bitaxeorg/bitaxeproto/bitaxeProto.kicad_pcb

## KiCad design bitaxeProto.kicad_pcb (2026-08-12)

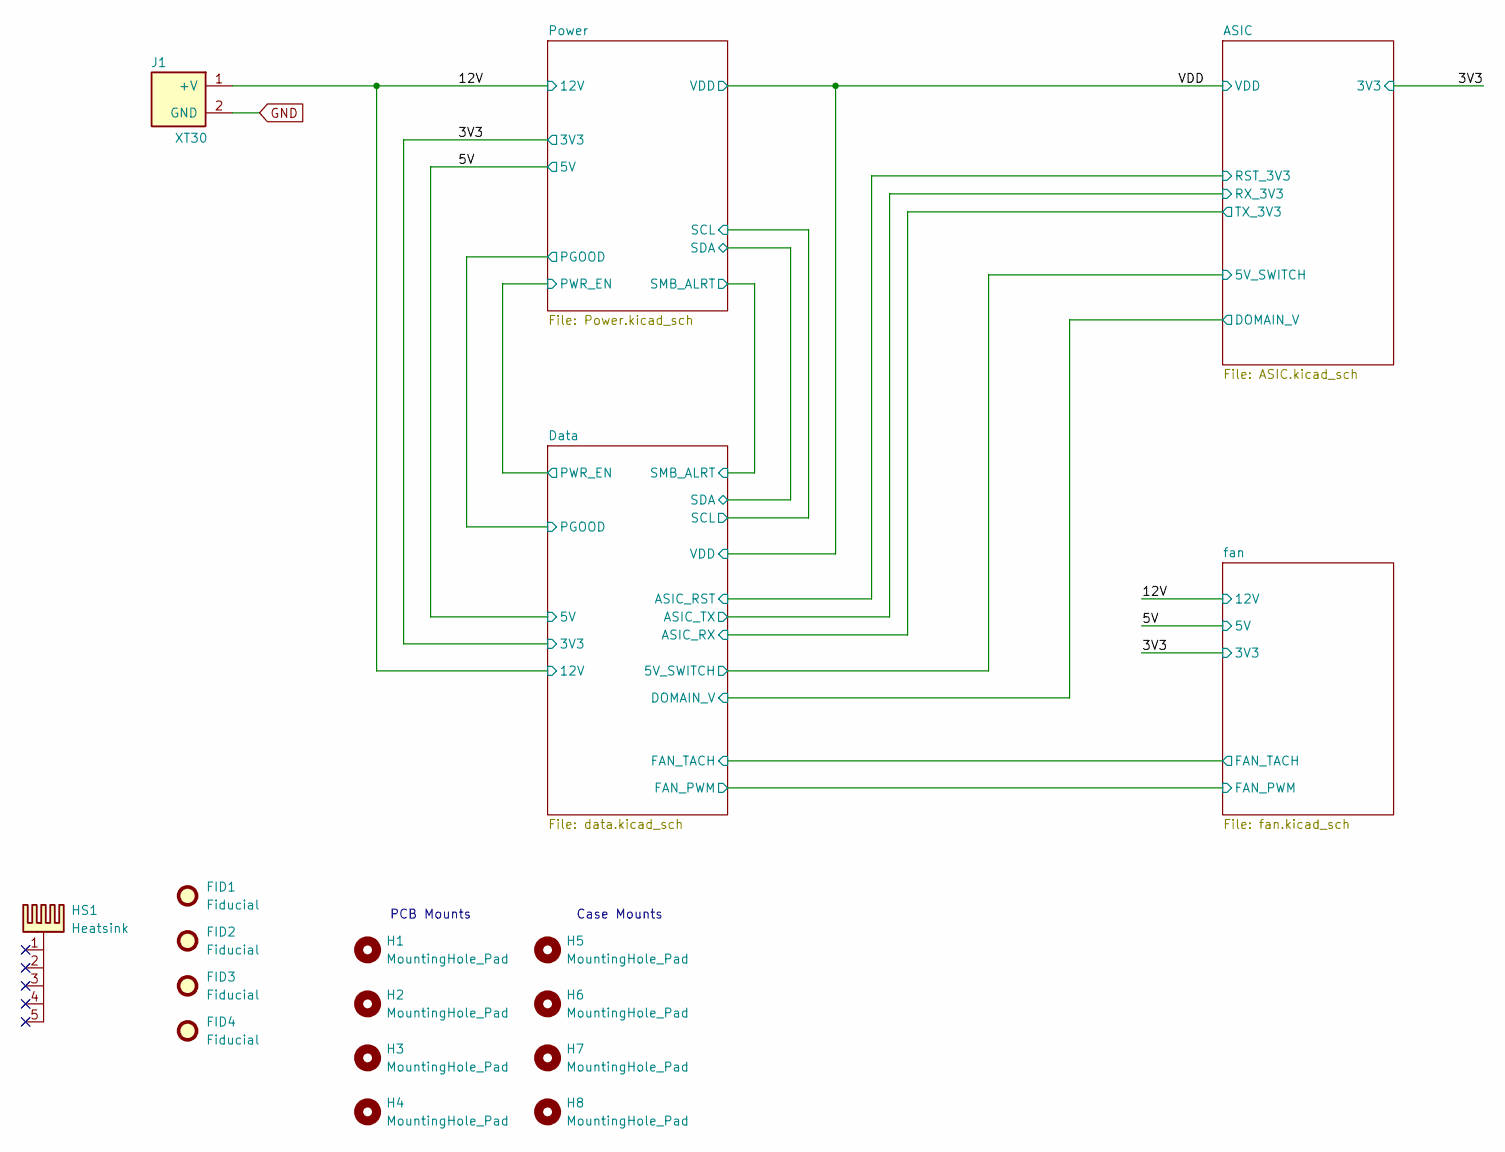
[picture p1: schematic bitaxeProto.kicad_sch]

Parts:
FID1, FID2, FID3, FID4: Fiducial; Fiducial_1mm_Mask2mm
H1, H2, H3, H4, H5, H6, H7, H8: MountingHole_Pad; MountingHole_3.2mm_M3
HS1: Heatsink; Heatsink-5hole-BitaxeGT
J1: XT30; XT30PW-M; PARTNO XT30PW-M30.G.Y; LCSC C431092

Connections:
/12V: J1.1 (+V); also elsewhere on the board
GND: J1.2 (GND); also elsewhere on the board

Notes on the sheet:
Case Mounts
PCB Mounts

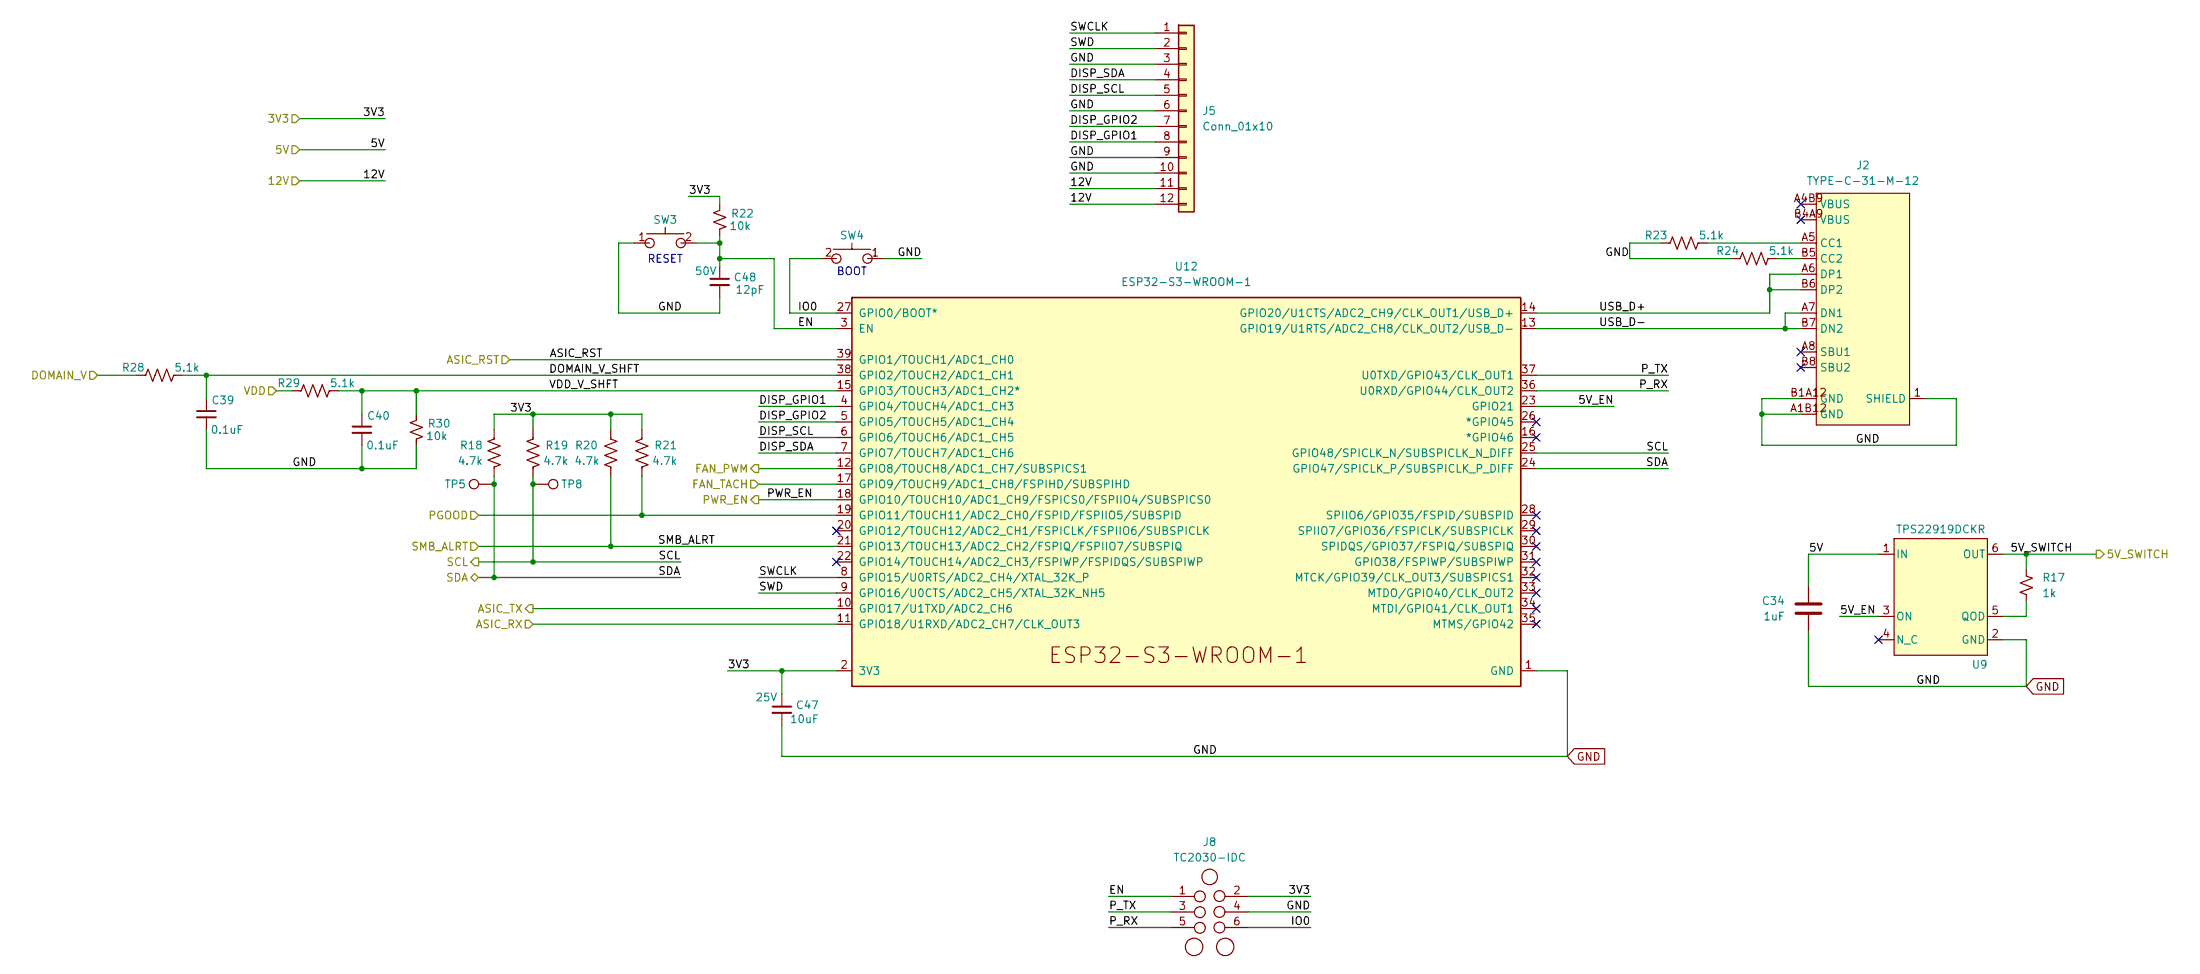
[picture p2: schematic data.kicad_sch, bitaxeProto]

Parts:
C34: 1uF; C_0402_1005Metric; PARTNO CL05A105KA5NQNC; LCSC C52923
C39, C40: 0.1uF; C_0402_1005Metric; Voltage 50V; PARTNO CL05B104KB54PNC; LCSC C307331
C47: 10uF; C_0603_1608Metric; Voltage 25V; PARTNO CL10A106MA8NRNC; LCSC C96446
C48: 12pF; C_0402_1005Metric; Voltage 50V; PARTNO 0402CG120J500NT; LCSC C1547
J2: TYPE-C-31-M-12; USB-C_SMD-TYPE-C-31-M-12_1; PARTNO TYPE-C-31-M-12; LCSC C165948
J5: Conn_01x10; CONN12_1-1735042-2; PARTNO 1-1735042-0
J8: TC2030-IDC; Tag-Connect_TC2030-IDC-NL_2x03_P1.27mm_Vertical
R17: 1k; R_0402_1005Metric; PARTNO 0402WGF1001TCE; LCSC C11702
R18, R19, R20, R21: 4.7k; R_0402_1005Metric; PARTNO 0402WGF4701TCE; LCSC C25900
R22, R30: 10k; R_0402_1005Metric; PARTNO 0402WGF1002TCE; LCSC C25744
R23, R24, R28, R29: 5.1k; R_0402_1005Metric; PARTNO 0402WGF5101TCE; LCSC C25905
SW3, SW4: SWITCH-SPST; SW-SMD_TC-S3601-3.5-260G-F0.6; PARTNO TC-S3601-3.5-260G-F0.6; LCSC C49101620
TP5: SDA; TestPoint_Pad_D1.0mm
TP8: SCL; TestPoint_Pad_D1.0mm
U9: TPS22919DCKR; DCK0006A_N; PARTNO TPS22919DCKR; LCSC C2149796
U12: ESP32-S3-WROOM-1; PARTNO ESP32-S3-WROOM-1-N16R8; LCSC C2913202

Connections:
/3V3: C47.1, J8.2, R18.1, R19.2, R20.2, R21.2, R22.2, U12.2 (3V3); also elsewhere on the board
/5V: C34.1, U9.1 (IN); also elsewhere on the board
/12V: J5.11, J5.12; also elsewhere on the board
/ASIC/5V_SWITCH: R17.1, U9.6 (OUT); also elsewhere on the board
/ASIC/GND0: R28.1; also elsewhere on the board
/ASIC/RX_3V3: U12.10 (GPIO17/U1TXD/ADC2_CH6); also elsewhere on the board
/ASIC/TX_3V3: U12.11 (GPIO18/U1RXD/ADC2_CH7/CLK_OUT3); also elsewhere on the board
/Data/5V_EN: U9.3 (ON), U12.23 (GPIO21)
/Data/ASIC_RST: U12.39 (GPIO1/TOUCH1/ADC1_CH0); also elsewhere on the board
/Data/DISP_GPIO1: J5.8, U12.4 (GPIO4/TOUCH4/ADC1_CH3)
/Data/DISP_GPIO2: J5.7, U12.5 (GPIO5/TOUCH5/ADC1_CH4)
/Data/DISP_SCL: J5.5, U12.6 (GPIO6/TOUCH6/ADC1_CH5)
/Data/DISP_SDA: J5.4, U12.7 (GPIO7/TOUCH7/ADC1_CH6)
/Data/DOMAIN_V_SHFT: C39.1, R28.2, U12.38 (GPIO2/TOUCH2/ADC1_CH1)
/Data/EN: C48.1, J8.1, R22.1, SW3.2, U12.3 (EN)
/Data/FAN_PWM: U12.12 (GPIO8/TOUCH8/ADC1_CH7/SUBSPICS1); also elsewhere on the board
/Data/FAN_TACH: U12.17 (GPIO9/TOUCH9/ADC1_CH8/FSPIHD/SUBSPIHD); also elsewhere on the board
/Data/IO0: J8.6, SW4.2, U12.27 (GPIO0/BOOT*)
/Data/PWR_EN: U12.18 (GPIO10/TOUCH10/ADC1_CH9/FSPICS0/FSPIIO4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); also elsewhere on the board
/Data/P_RX: J8.5, U12.36 (U0RXD/GPIO44/CLK_OUT2)
/Data/P_TX: J8.3, U12.37 (U0TXD/GPIO43/CLK_OUT1)
/Data/SCL: R19.1, TP8.1 (1_1), U12.25 (GPIO48/SPICLK_N/SUBSPICLK_N_DIFF); also elsewhere on the board
/Data/SDA: R18.2, TP5.1 (1_1), U12.24 (GPIO47/SPICLK_P/SUBSPICLK_P_DIFF); also elsewhere on the board
/Data/SMB_ALRT: R20.1, U12.21 (GPIO13/TOUCH13/ADC2_CH2/FSPIQ/FSPIIO7/S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); also elsewhere on the board
/Data/SWCLK: J5.1, U12.8 (GPIO15/U0RTS/ADC2_CH4/XTAL_32K_P)
/Data/SWD: J5.2, U12.9 (GPIO16/U0CTS/ADC2_CH5/XTAL_32K_NH5)
/Data/USB_D+: J2.A6 (DP1), J2.B6 (DP2), U12.14 (GPIO20/U1CTS/ADC2_CH9/CLK_OUT1/USB_D+)
/Data/USB_D-: J2.A7 (DN1), J2.B7 (DN2), U12.13 (GPIO19/U1RTS/ADC2_CH8/CLK_OUT2/USB_D-)
/Data/VDD_V_SHFT: C40.1, R29.2, R30.2, U12.15 (GPIO3/TOUCH3/ADC1_CH2*)
/Power/PGOOD: R21.1, U12.19 (GPIO11/TOUCH11/ADC2_CH0/FSPID/FSPIIO5/S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); also elsewhere on the board
/VDD: R29.1; also elsewhere on the board
GND: C34.2, C39.2, C40.2, C47.2, C48.2, J2.1 (SHIELD), J2.2 (EH), J2.3 (EH), J2.4 (EH), J2.A1B12 (GND), J2.B1A12 (GND), J5.3, J5.6, J5.9, J5.10, J8.4, R23.1, R24.1, R30.1, SW3.1, SW4.1, U9.2 (GND), U12.1 (GND), U12.40 (GND), U12.41 (GND); also elsewhere on the board
unnamed: J2.A5 (CC1), R23.2
unnamed: J2.B5 (CC2), R24.2
unnamed: R17.2, U9.5 (QOD)

Notes on the sheet:
BOOT
RESET

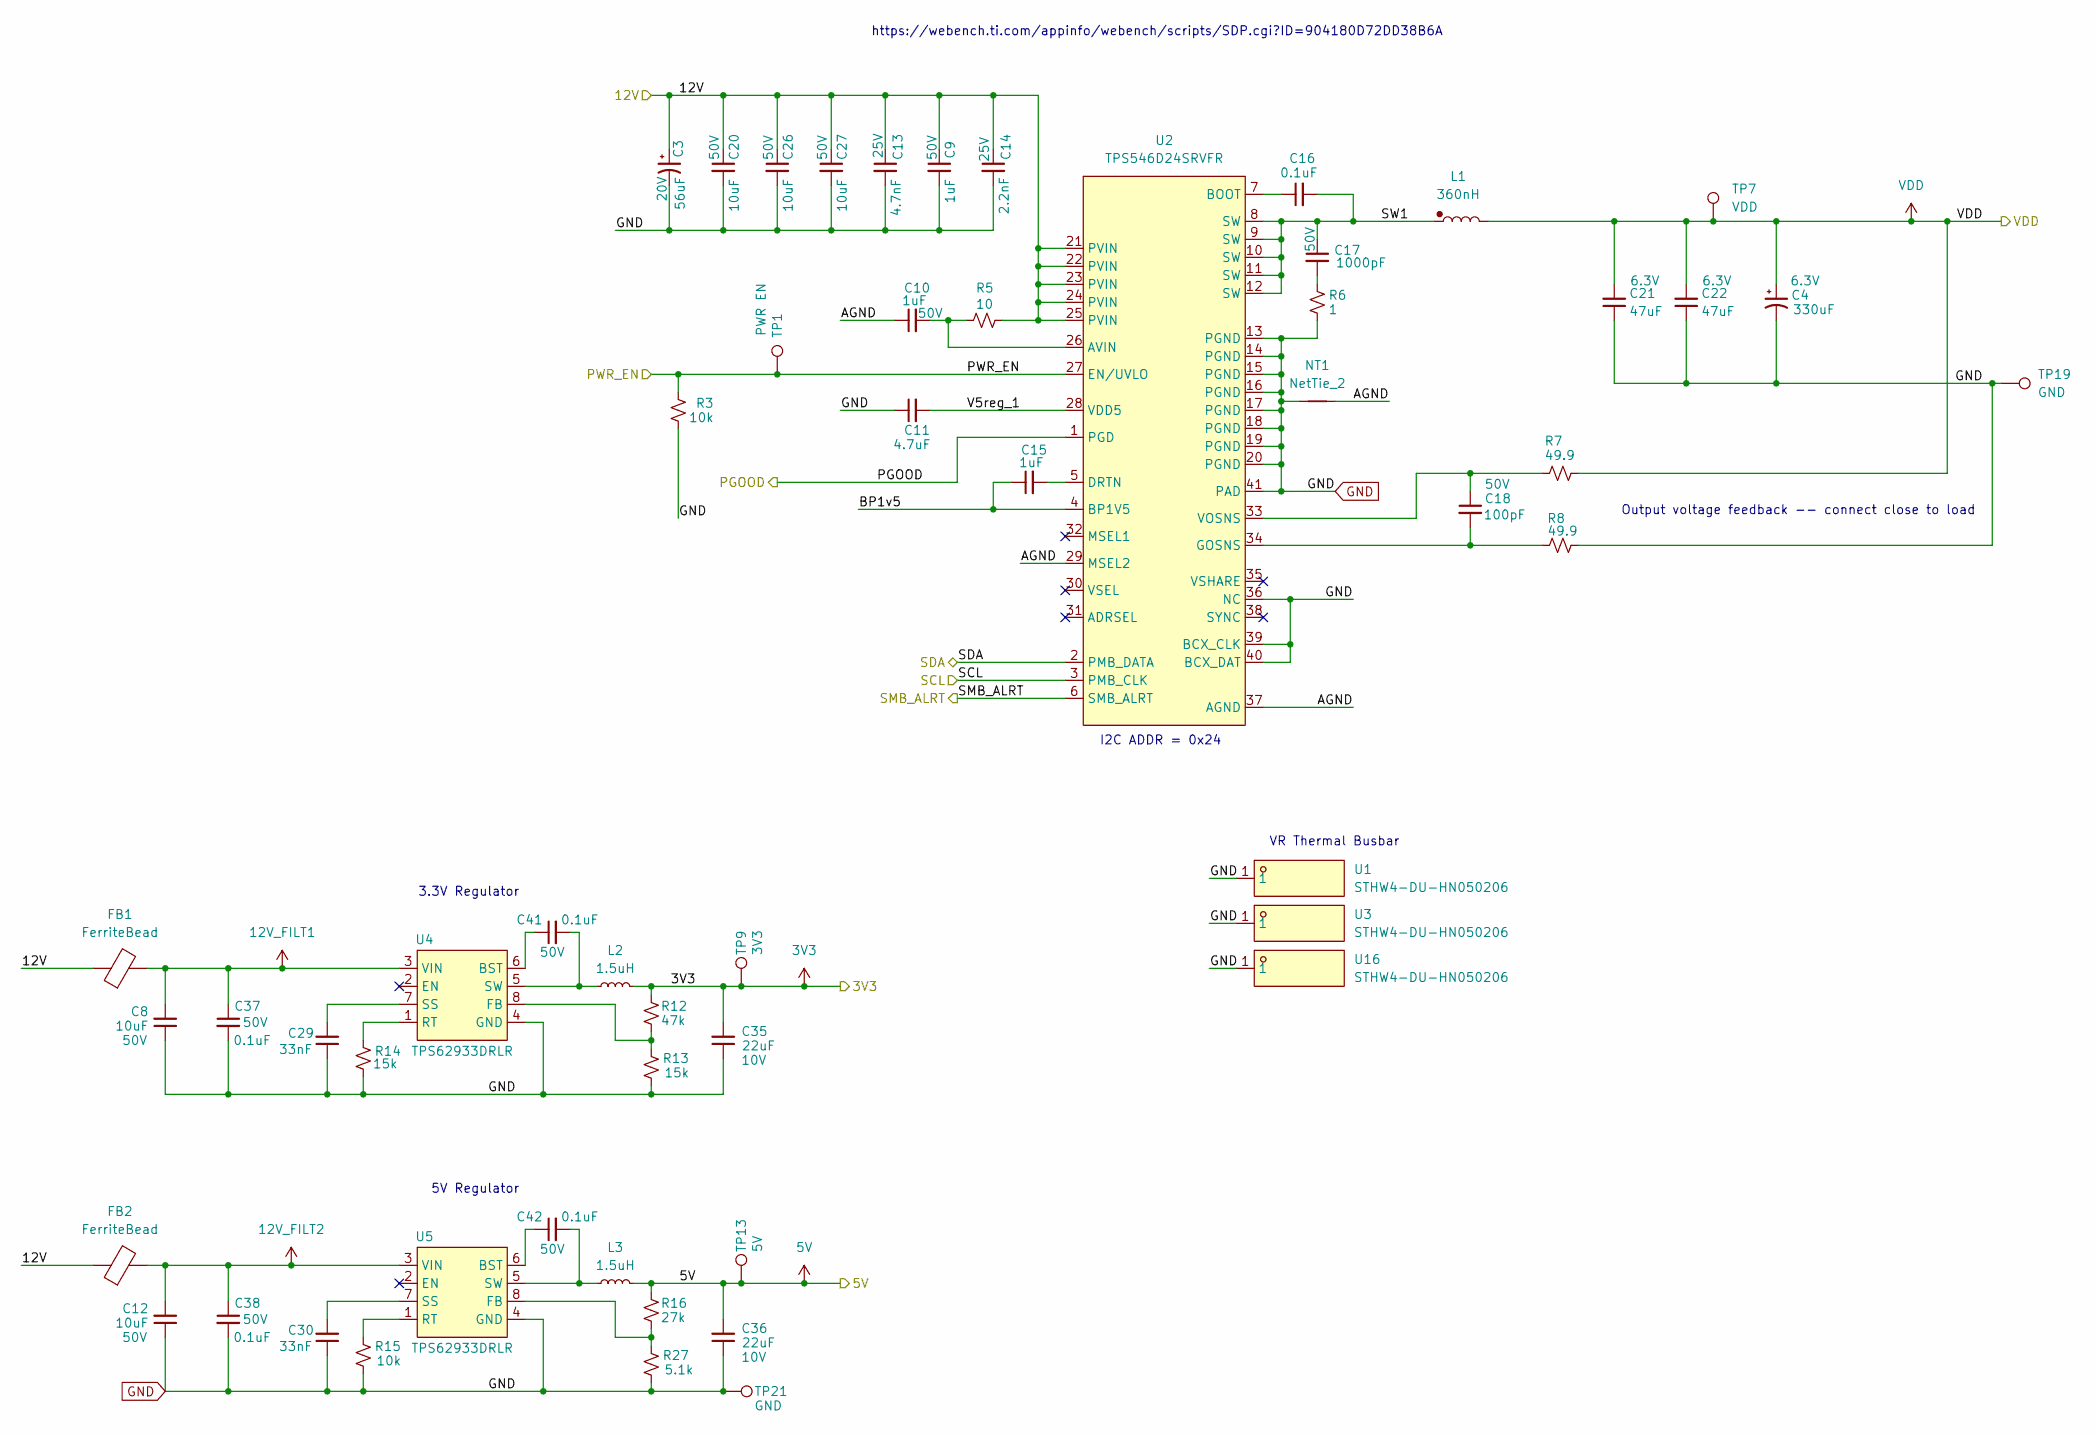
[picture p3: schematic Power.kicad_sch, bitaxeProto]

Parts:
C3: 56uF; CP_Elec_5x5.3; Voltage 20V; PARTNO 20SVPF56MX; LCSC C2162042
C4: 330uF; CP_Elec_6.3x7.7; Voltage 6.3V; PARTNO APXF6R3ARA331MF61G; LCSC C133476
C8, C12, C20, C26, C27: 10uF; C_1210_3225Metric; Voltage 50V; PARTNO CL32B106KBJNNNE; LCSC C138687
C9, C10: 1uF; C_0805_2012Metric; Voltage 50V; PARTNO CL21B105KBFNNNE; LCSC C28323
C11: 4.7uF; C_0402_1005Metric; PARTNO CL05A475MP5NRNC; LCSC C23733
C13: 4.7nF; C_0402_1005Metric; Voltage 25V; PARTNO 0402B472K500NT; LCSC C1538
C14: 2.2nF; C_0402_1005Metric; Voltage 25V; PARTNO 0402B222K500NT; LCSC C1531
C15: 1uF; C_0402_1005Metric; PARTNO CL05A105KA5NQNC; LCSC C52923
C16, C37, C38, C41, C42: 0.1uF; C_0402_1005Metric; Voltage 50V; PARTNO CL05B104KB54PNC; LCSC C307331
C17: 1000pF; C_0805_2012Metric; Voltage 50V; PARTNO CL21B102KBCNNNC; LCSC C46653
C18: 100pF; C_0402_1005Metric; Voltage 50V; PARTNO 0402CG101J500NT; LCSC C1546
C21, C22: 47uF; C_0805_2012Metric; Voltage 6.3V; PARTNO CL21A476MQYNNNE; LCSC C16780
C29, C30: 33nF; C_0603_1608Metric; PARTNO CL10B333KB8NNNC; LCSC C21117
C35, C36: 22uF; C_0805_2012Metric; Voltage 10V; PARTNO CL21A226MAQNNNE; LCSC C45783
FB1, FB2: FerriteBead; L_1206_3216Metric; PARTNO BLM31KN271SN1L; LCSC C703115
L1: 360nH; IND-SMD_L13.8-W12.6; PARTNO MS1350-R36M; LCSC C380062
L2, L3: 1.5uH; IND-SMD_L2.0-W1.6; PARTNO FTC201612S1R5MBCA; LCSC C5832350
NT1: NetTie_2; NetTie-2_SMD_Pad0.2mmx1mm
R3, R15: 10k; R_0402_1005Metric; PARTNO 0402WGF1002TCE; LCSC C25744
R5: 10; R_0402_1005Metric; PARTNO 0402WGF100JTCE; LCSC C25077
R6: 1; R_0805_2012Metric; PARTNO ESR10EZPJ1R0; LCSC C253344
R7, R8: 49.9; R_0402_1005Metric; PARTNO 0402WGF499JTCE; LCSC C25120
R12: 47k; R_0402_1005Metric; PARTNO 0402WGF4702TCE; LCSC C25792
R13, R14: 15k; R_0402_1005Metric; PARTNO 0402WGF1502TCE; LCSC C25756
R16: 27k; R_0402_1005Metric; PARTNO 0402WGF2702TCE; LCSC C25771
R27: 5.1k; R_0402_1005Metric; PARTNO 0402WGF5101TCE; LCSC C25905
TP1: PWR EN; TestPoint_Pad_D1.0mm
TP7: VDD; TestPoint_Pad_D1.0mm
TP9: 3V3; TestPoint_Pad_D1.0mm
TP13: 5V; TestPoint_Pad_D1.0mm
TP19, TP21: GND; TestPoint_Pad_D1.0mm
U1, U3, U16: STHW4-DU-HN050206; PAD-SMD_L5.0-W2.0_STHW4-DU-HN050206; PARTNO STHW4-DU-HN050206; LCSC C18548300
U2: TPS546D24SRVFR; LQFN40-CLIP; PARTNO TPS546D24SRVFR; LCSC C20345977
U4, U5: TPS62933DRLR; SOT-583-8_L2.1-W1.2-P0.50-LS1.6-BR; PARTNO TPS62933DRLR; LCSC C3200405

Connections:
/3V3: C35.2, L2.2, R12.2, TP9.1 (1_1); also elsewhere on the board
/5V: C36.2, L3.2, R16.2, TP13.1 (1_1); also elsewhere on the board
/12V: C3.1, C9.1, C13.1, C14.1, C20.1, C26.1, C27.1, FB1.1, FB2.1, R5.1, U2.21 (PVIN), U2.22 (PVIN), U2.23 (PVIN), U2.24 (PVIN), U2.25 (PVIN); also elsewhere on the board
/Data/PWR_EN: R3.2, TP1.1 (1_1), U2.27 (EN/UVLO); also elsewhere on the board
/Data/SCL: U2.3 (PMB_CLK); also elsewhere on the board
/Data/SDA: U2.2 (PMB_DATA); also elsewhere on the board
/Data/SMB_ALRT: U2.6 (SMB_ALRT); also elsewhere on the board
/Power/AGND: C10.1, NT1.2, U2.29 (MSEL2), U2.37 (AGND)
/Power/BP1v5: C15.1, U2.4 (BP1V5)
/Power/PGOOD: U2.1 (PGD); also elsewhere on the board
/Power/SW1: C16.2, C17.1, L1.1, U2.8 (SW), U2.9 (SW), U2.10 (SW), U2.11 (SW), U2.12 (SW)
/Power/V5reg_1: C11.2, U2.28 (VDD5)
/VDD: C4.1, C21.2, C22.2, L1.2, R7.1, TP7.1 (1_1); also elsewhere on the board
GND: C3.2, C4.2, C8.1, C9.2, C11.1, C12.1, C13.2, C14.2, C20.2, C21.1, C22.1, C26.2, C27.2, C29.1, C30.1, C35.1, C36.1, C37.2, C38.2, NT1.1, R3.1, R6.2, R8.2, R13.1, R14.1, R15.1, R27.1, TP19.1 (1_1), TP21.1 (1_1), U1.1 (1_1), U2.13 (PGND), U2.14 (PGND), U2.15 (PGND), U2.16 (PGND), U2.17 (PGND), U2.18 (PGND), U2.19 (PGND), U2.20 (PGND), U2.36 (NC), U2.39 (BCX_CLK), U2.40 (BCX_DAT), U2.41 (PAD), U3.1 (1_1), U4.4 (GND), U5.4 (GND), U16.1 (1_1); also elsewhere on the board
unnamed: C17.2, R6.1
unnamed: C10.2, R5.2, U2.26 (AVIN)
unnamed: C16.1, U2.7 (BOOT)
unnamed: C15.2, U2.5 (DRTN)
unnamed: C18.2, R8.1, U2.34 (GOSNS)
unnamed: C18.1, R7.2, U2.33 (VOSNS)
unnamed: C41.1, U4.6 (BST)
unnamed: R12.1, R13.2, U4.8 (FB)
unnamed: R14.2, U4.1 (RT)
unnamed: C29.2, U4.7 (SS)
unnamed: C41.2, L2.1, U4.5 (SW)
unnamed: C8.2, C37.1, FB1.2, U4.3 (VIN)
unnamed: C42.1, U5.6 (BST)
unnamed: R16.1, R27.2, U5.8 (FB)
unnamed: R15.2, U5.1 (RT)
unnamed: C30.2, U5.7 (SS)
unnamed: C42.2, L3.1, U5.5 (SW)
unnamed: C12.2, C38.1, FB2.2, U5.3 (VIN)

Notes on the sheet:
I2C ADDR = 0x24
3.3V Regulator
VR Thermal Busbar
5V Regulator
Output voltage feedback -- connect close to load
https://webench.ti.com/appinfo/webench/scripts/SDP.cgi?ID=904180D72DD38B6A

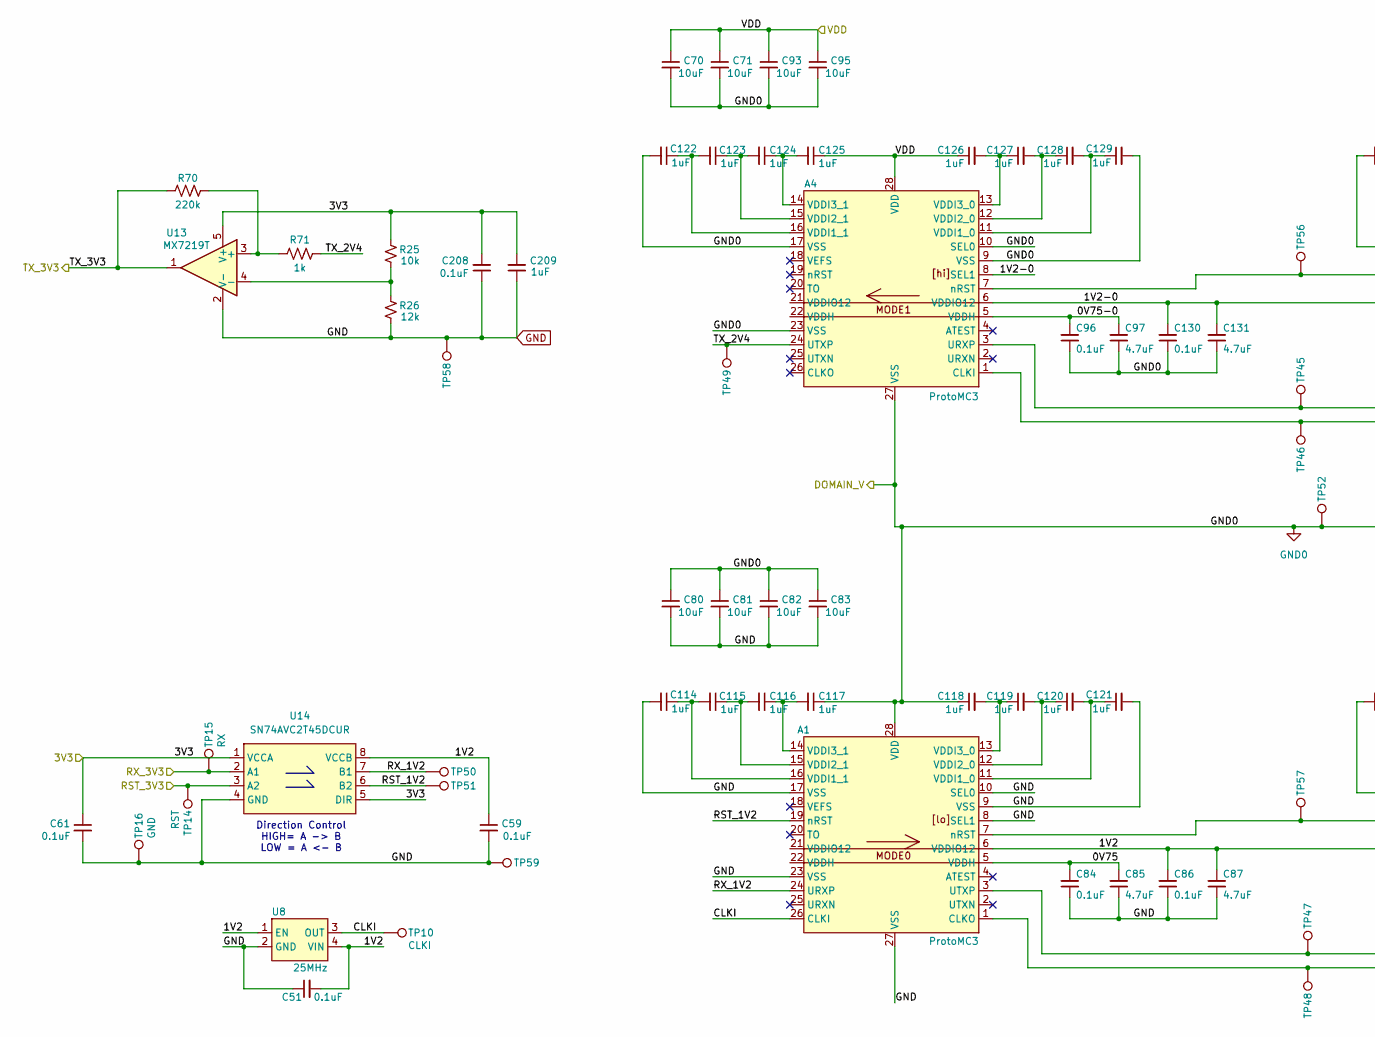
[picture p4: schematic ASIC.kicad_sch, bitaxeProto, part in row 1, column 1]

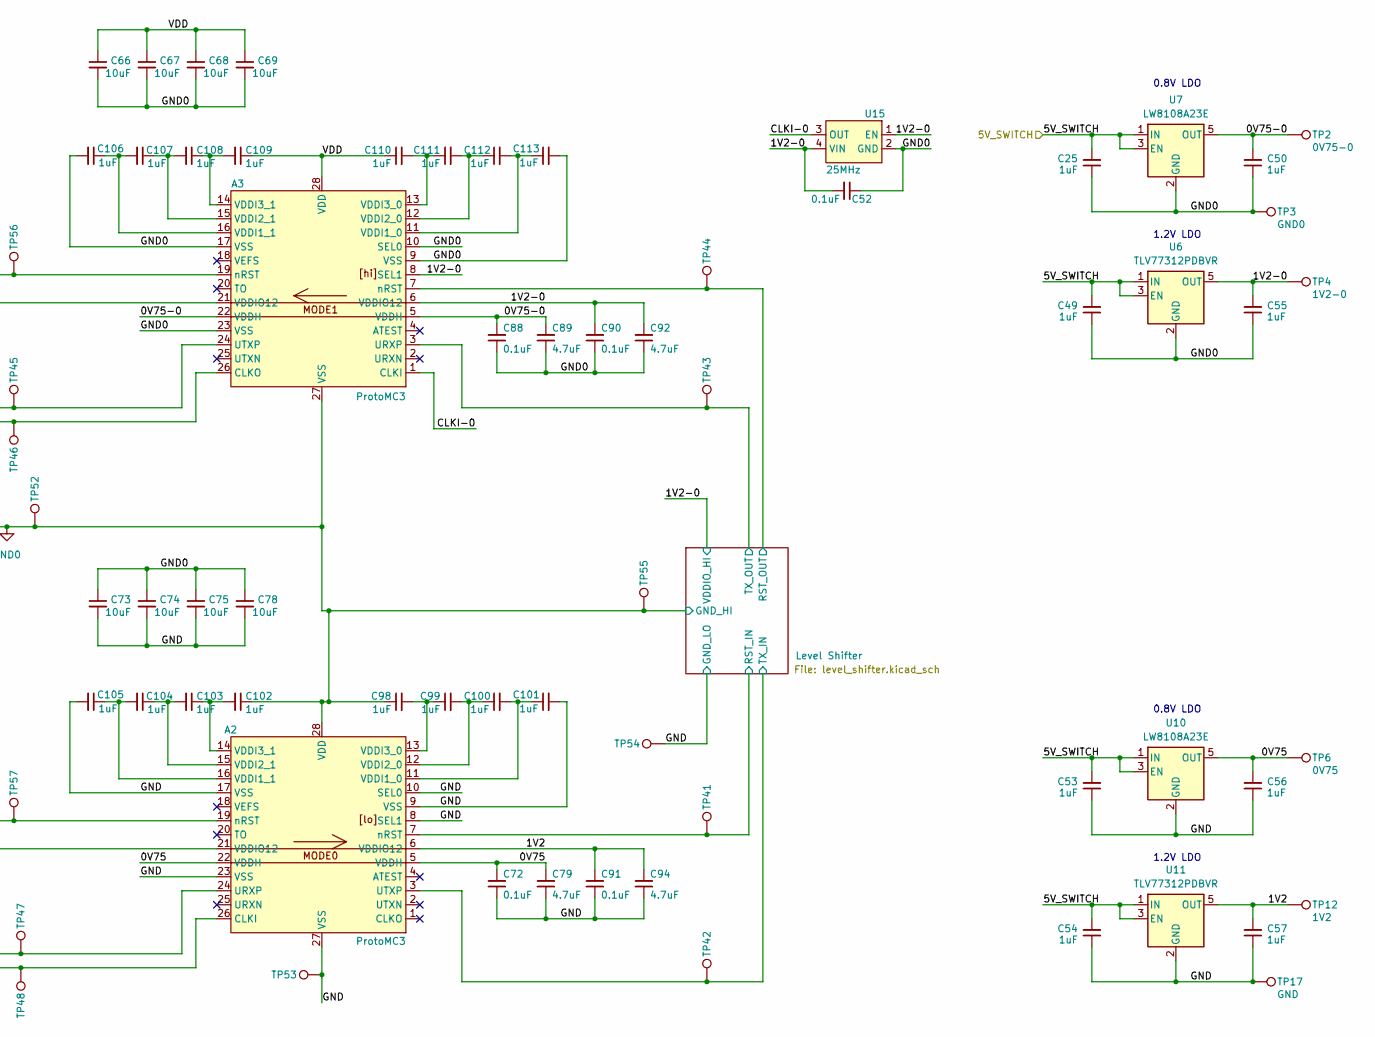
[picture p5: schematic ASIC.kicad_sch, bitaxeProto, part in row 1, column 2]

Parts:
A1, A2, A3, A4: ProtoMC3; proto-mc3
C25, C49, C50, C53, C54, C55, C56, C57, C98, C99, C100, C101, C102, C103, C104, C105, C106, C107, C108, C109, C110, C111, C112, C113, C114, C115, C116, C117, C118, C119, C120, C121, C122, C123, C124, C125, C126, C127, C128, C129, C209: 1uF; C_0402_1005Metric; PARTNO CL05A105KA5NQNC; LCSC C52923
C51, C52, C59, C61, C72, C84, C86, C88, C90, C91, C96, C130, C208: 0.1uF; C_0402_1005Metric; Voltage 50V; PARTNO CL05B104KB54PNC; LCSC C307331
C66, C67, C68, C69, C70, C71, C73, C74, C75, C78, C80, C81, C82, C83, C93, C95: 10uF; C_0603_1608Metric; Voltage 25V; PARTNO CL10A106MA8NRNC; LCSC C96446
C79, C85, C87, C89, C92, C94, C97, C131: 4.7uF; C_0402_1005Metric; PARTNO CL05A475MP5NRNC; LCSC C23733
R25: 10k; R_0402_1005Metric; PARTNO 0402WGF1002TCE; LCSC C25744
R26: 12k; R_0402_1005Metric; PARTNO 0402WGF1202TCE; LCSC C25752
R70: 220k; R_0402_1005Metric; PARTNO RC0402FR-07220KL; LCSC C138030
R71: 1k; R_0402_1005Metric; PARTNO 0402WGF1001TCE; LCSC C11702
TP2: 0V75-0; TestPoint_Pad_D1.0mm
TP3: GND0; TestPoint_Pad_D1.0mm
TP4: 1V2-0; TestPoint_Pad_D1.0mm
TP6: 0V75; TestPoint_Pad_D1.0mm
TP10: CLKI; TestPoint_Pad_D1.0mm
TP12: 1V2; TestPoint_Pad_D1.0mm
TP14: RST; TestPoint_Pad_D1.0mm
TP15: RX; TestPoint_Pad_D1.0mm
TP16, TP17: GND; TestPoint_Pad_D1.0mm
TP41, TP44, TP51, TP56, TP57: RST; TestPoint_Pad_1.0x0.4mm
TP42, TP49: TX; TestPoint_Pad_1.0x0.4mm
TP43, TP45, TP47, TP50: RX; TestPoint_Pad_1.0x0.4mm
TP46, TP48: CLK; TestPoint_Pad_1.0x0.4mm
TP52, TP53, TP54, TP55, TP58, TP59: GND; TestPoint_Pad_1.0x0.4mm
U6, U11: TLV77312PDBVR; SOT-23-5; PARTNO TLV77312PDBVR; LCSC C30806341
U7, U10: LW8108A23E; SOT-23-5; PARTNO LW8108A23E; LCSC C51953196
U8, U15: 25MHz; SMD3225-4P; PARTNO SX3M25.000E20F30THN; LCSC C5137262
U13: MX7219T; SOT-23-5; PARTNO MX7219T; LCSC C20882980
U14: SN74AVC2T45DCUR; VSSOP-8_L2.1-W2.4-P0.50-LS3.2-BR; PARTNO SN74AVC2T45DCUR; LCSC C140318

Connections:
/3V3: C61.1, C208.2, C209.2, R25.2, U13.5 (V+), U14.1 (VCCA), U14.5 (DIR); also elsewhere on the board
/ASIC/0V75: A1.5 (VDDH), A1.22 (VDDH), A2.5 (VDDH), A2.22 (VDDH), C56.2, C72.2, C79.2, C84.2, C85.2, TP6.1 (1_1), U10.5 (OUT)
/ASIC/0V75-0: A3.5 (VDDH), A3.22 (VDDH), A4.5 (VDDH), A4.22 (VDDH), C50.2, C88.2, C89.2, C96.2, C97.2, TP2.1 (1_1), U7.5 (OUT)
/ASIC/1V2: A1.6 (VDDIO12), A1.21 (VDDIO12), A2.6 (VDDIO12), A2.21 (VDDIO12), C51.2, C57.2, C59.1, C86.2, C87.2, C91.2, C94.2, TP12.1 (1_1), U8.1 (EN), U8.4 (VIN), U11.5 (OUT), U14.8 (VCCB)
/ASIC/1V2-0: A3.6 (VDDIO12), A3.8 (SEL1), A3.21 (VDDIO12), A4.6 (VDDIO12), A4.8 (SEL1), A4.21 (VDDIO12), C52.2, C55.2, C90.2, C92.2, C130.2, C131.2, TP4.1 (1_1), U6.5 (OUT), U15.1 (EN), U15.4 (VIN); also elsewhere on the board
/ASIC/5V_SWITCH: C25.2, C49.2, C53.2, C54.2, U6.1 (IN), U6.3 (EN), U7.1 (IN), U7.3 (EN), U10.1 (IN), U10.3 (EN), U11.1 (IN), U11.3 (EN); also elsewhere on the board
/ASIC/CLKI: A1.26 (CLKI), TP10.1 (1_1), U8.3 (OUT)
/ASIC/CLKI-0: A3.1 (CLKI), U15.3 (OUT)
/ASIC/GND0: A1.28 (VDD), A2.28 (VDD), A3.9 (VSS), A3.10 (SEL0), A3.17 (VSS), A3.23 (VSS), A3.27 (VSS), A4.9 (VSS), A4.10 (SEL0), A4.17 (VSS), A4.23 (VSS), A4.27 (VSS), C25.1, C49.1, C50.1, C52.1, C55.1, C66.2, C67.2, C68.2, C69.2, C70.2, C71.2, C73.1, C74.1, C75.1, C78.1, C80.1, C81.1, C82.1, C83.1, C88.1, C89.1, C90.1, C92.1, C93.2, C95.2, C96.1, C97.1, C98.1, C102.1, C106.2, C113.2, C117.1, C118.1, C122.2, C129.2, C130.1, C131.1, TP3.1 (1_1), TP52.1 (1_1), TP55.1 (1_1), U6.2 (GND), U7.2 (GND), U15.2 (GND); also elsewhere on the board
/ASIC/Level Shifter/RST_IN: A2.7 (nRST), TP41.1 (1_1); also elsewhere on the board
/ASIC/Level Shifter/RST_OUT: A3.7 (nRST), TP44.1 (1_1); also elsewhere on the board
/ASIC/Level Shifter/TX_IN: A2.3 (UTXP), TP42.1 (1_1); also elsewhere on the board
/ASIC/Level Shifter/TX_OUT: A3.3 (URXP), TP43.1 (1_1); also elsewhere on the board
/ASIC/RST_1V2: A1.19 (nRST), TP51.1 (1_1), U14.6 (B2)
/ASIC/RX_1V2: A1.24 (URXP), TP50.1 (1_1), U14.7 (B1)
/ASIC/RX_3V3: TP15.1 (1_1), U14.2 (A1); also elsewhere on the board
/ASIC/TX_2V4: A4.24 (UTXP), R71.1, TP49.1 (1_1)
/ASIC/TX_3V3: R70.2, U13.1; also elsewhere on the board
/Data/ASIC_RST: TP14.1 (1_1), U14.3 (A2); also elsewhere on the board
/VDD: A3.28 (VDD), A4.28 (VDD), C66.1, C67.1, C68.1, C69.1, C70.1, C71.1, C93.1, C95.1, C109.1, C110.1, C125.1, C126.1; also elsewhere on the board
GND: A1.8 (SEL1), A1.9 (VSS), A1.10 (SEL0), A1.17 (VSS), A1.23 (VSS), A1.27 (VSS), A2.8 (SEL1), A2.9 (VSS), A2.10 (SEL0), A2.17 (VSS), A2.23 (VSS), A2.27 (VSS), C51.1, C53.1, C54.1, C56.1, C57.1, C59.2, C61.2, C72.1, C73.2, C74.2, C75.2, C78.2, C79.1, C80.2, C81.2, C82.2, C83.2, C84.1, C85.1, C86.1, C87.1, C91.1, C94.1, C101.2, C105.2, C114.2, C121.2, C208.1, C209.1, R26.1, TP16.1 (1_1), TP17.1 (1_1), TP53.1 (1_1), TP54.1 (1_1), TP58.1 (1_1), TP59.1 (1_1), U8.2 (GND), U10.2 (GND), U11.2 (GND), U13.2 (V-), U14.4 (GND); also elsewhere on the board
unnamed: A1.1 (CLKO), A2.26 (CLKI), TP48.1 (1_1)
unnamed: A1.3 (UTXP), A2.24 (URXP), TP47.1 (1_1)
unnamed: A1.11 (VDDI1_0), C120.2, C121.1
unnamed: A1.16 (VDDI1_1), C114.1, C115.2
unnamed: A1.12 (VDDI2_0), C119.2, C120.1
unnamed: A1.15 (VDDI2_1), C115.1, C116.2
unnamed: A1.13 (VDDI3_0), C118.2, C119.1
unnamed: A1.14 (VDDI3_1), C116.1, C117.2
unnamed: A1.7 (nRST), A2.19 (nRST), TP57.1 (1_1)
unnamed: A2.11 (VDDI1_0), C100.2, C101.1
unnamed: A2.16 (VDDI1_1), C104.2, C105.1
unnamed: A2.12 (VDDI2_0), C99.2, C100.1
unnamed: A2.15 (VDDI2_1), C103.2, C104.1
unnamed: A2.13 (VDDI3_0), C98.2, C99.1
unnamed: A2.14 (VDDI3_1), C102.2, C103.1
unnamed: A3.26 (CLKO), A4.1 (CLKI), TP46.1 (1_1)
unnamed: A3.24 (UTXP), A4.3 (URXP), TP45.1 (1_1)
unnamed: A3.11 (VDDI1_0), C112.2, C113.1
unnamed: A3.16 (VDDI1_1), C106.1, C107.2
unnamed: A3.12 (VDDI2_0), C111.2, C112.1
unnamed: A3.15 (VDDI2_1), C107.1, C108.2
unnamed: A3.13 (VDDI3_0), C110.2, C111.1
unnamed: A3.14 (VDDI3_1), C108.1, C109.2
unnamed: A3.19 (nRST), A4.7 (nRST), TP56.1 (1_1)
unnamed: A4.11 (VDDI1_0), C128.2, C129.1
unnamed: A4.16 (VDDI1_1), C122.1, C123.2
unnamed: A4.12 (VDDI2_0), C127.2, C128.1
unnamed: A4.15 (VDDI2_1), C123.1, C124.2
unnamed: A4.13 (VDDI3_0), C126.2, C127.1
unnamed: A4.14 (VDDI3_1), C124.1, C125.2
unnamed: R70.1, R71.2, U13.3 (+)
unnamed: R25.1, R26.2, U13.4 (-)

Notes on the sheet:
1.2V LDO
Direction Control HIGH= A -> B LOW = A <- B
0.8V LDO

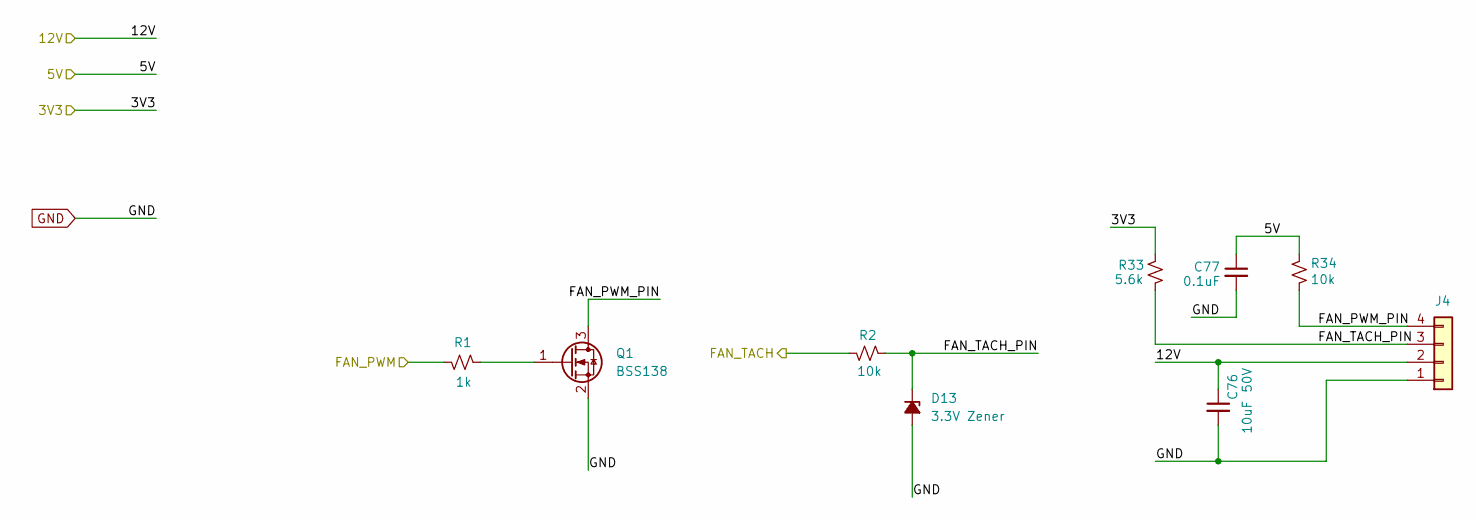
[picture p6: schematic fan.kicad_sch, bitaxeProto]

Parts:
C76: 10uF; C_1210_3225Metric; Voltage 50V; PARTNO CL32B106KBJNNNE; LCSC C138687
C77: 0.1uF; C_0402_1005Metric; Voltage 50V; PARTNO CL05B104KB54PNC; LCSC C307331
D13: 3.3V Zener; D_SOD-123; PARTNO MMSZ4684T1G; LCSC C24672
J4: Conn_01x04; fan_connector; PARTNO 0470531000
Q1: BSS138; SOT-23; PARTNO BSS138; LCSC C7420339
R1: 1k; R_0402_1005Metric; PARTNO 0402WGF1001TCE; LCSC C11702
R2, R34: 10k; R_0402_1005Metric; PARTNO 0402WGF1002TCE; LCSC C25744
R33: 5.6k; R_0402_1005Metric; PARTNO 0402WGF5601TCE; LCSC C25908

Connections:
/3V3: R33.2; also elsewhere on the board
/5V: C77.1, R34.2; also elsewhere on the board
/12V: C76.1, J4.2; also elsewhere on the board
/Data/FAN_PWM: R1.2; also elsewhere on the board
/Data/FAN_TACH: R2.2; also elsewhere on the board
/fan/FAN_PWM_PIN: J4.4, Q1.3 (D), R34.1
/fan/FAN_TACH_PIN: D13.1 (K), J4.3, R2.1, R33.1
GND: C76.2, C77.2, D13.2 (A), J4.1, Q1.2 (S); also elsewhere on the board
unnamed: Q1.1 (G), R1.1

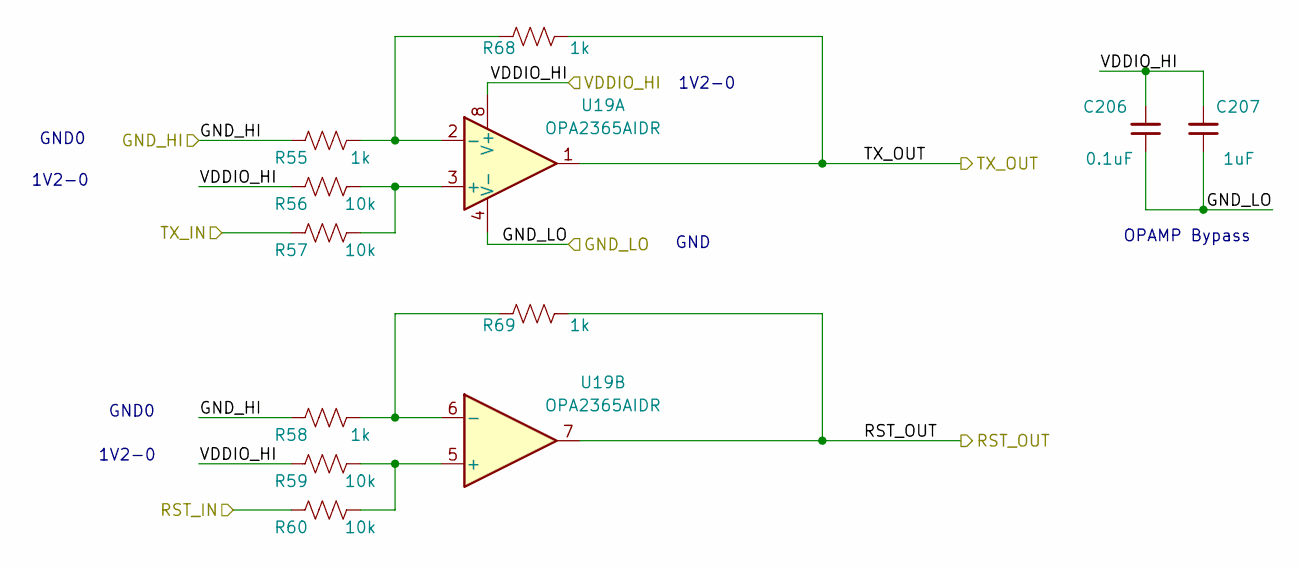
[picture p7: schematic level_shifter.kicad_sch, bitaxeProto]

Parts:
C206: 0.1uF; C_0402_1005Metric; Voltage 50V; PARTNO CL05B104KB54PNC; LCSC C307331
C207: 1uF; C_0402_1005Metric; PARTNO CL05A105KA5NQNC; LCSC C52923
R55, R58, R68, R69: 1k; R_0402_1005Metric; PARTNO 0402WGF1001TCE; LCSC C11702
R56, R57, R59, R60: 10k; R_0402_1005Metric; PARTNO 0402WGF1002TCE; LCSC C25744
U19: OPA2365AIDR; D8_TEX; PARTNO OPA2365AIDR; LCSC C130011

Connections:
/ASIC/1V2-0: C206.2, C207.2, R56.2, R59.1, U19.8 (V+); also elsewhere on the board
/ASIC/GND0: R55.2, R58.2; also elsewhere on the board
/ASIC/Level Shifter/RST_IN: R60.1; also elsewhere on the board
/ASIC/Level Shifter/RST_OUT: R69.1, U19.7; also elsewhere on the board
/ASIC/Level Shifter/TX_IN: R57.1; also elsewhere on the board
/ASIC/Level Shifter/TX_OUT: R68.1, U19.1; also elsewhere on the board
GND: C206.1, C207.1, U19.4 (V-); also elsewhere on the board
unnamed: R56.1, R57.2, U19.3 (+)
unnamed: R55.1, R68.2, U19.2 (-)
unnamed: R59.2, R60.2, U19.5 (+)
unnamed: R58.1, R69.2, U19.6 (-)

Notes on the sheet:
1V2-0
GND0
GND
OPAMP Bypass
