bitaxeorg/bitaxeproto/bitaxeProto.kicad_pcb

## KiCad design bitaxeProto.kicad_pcb (continued)

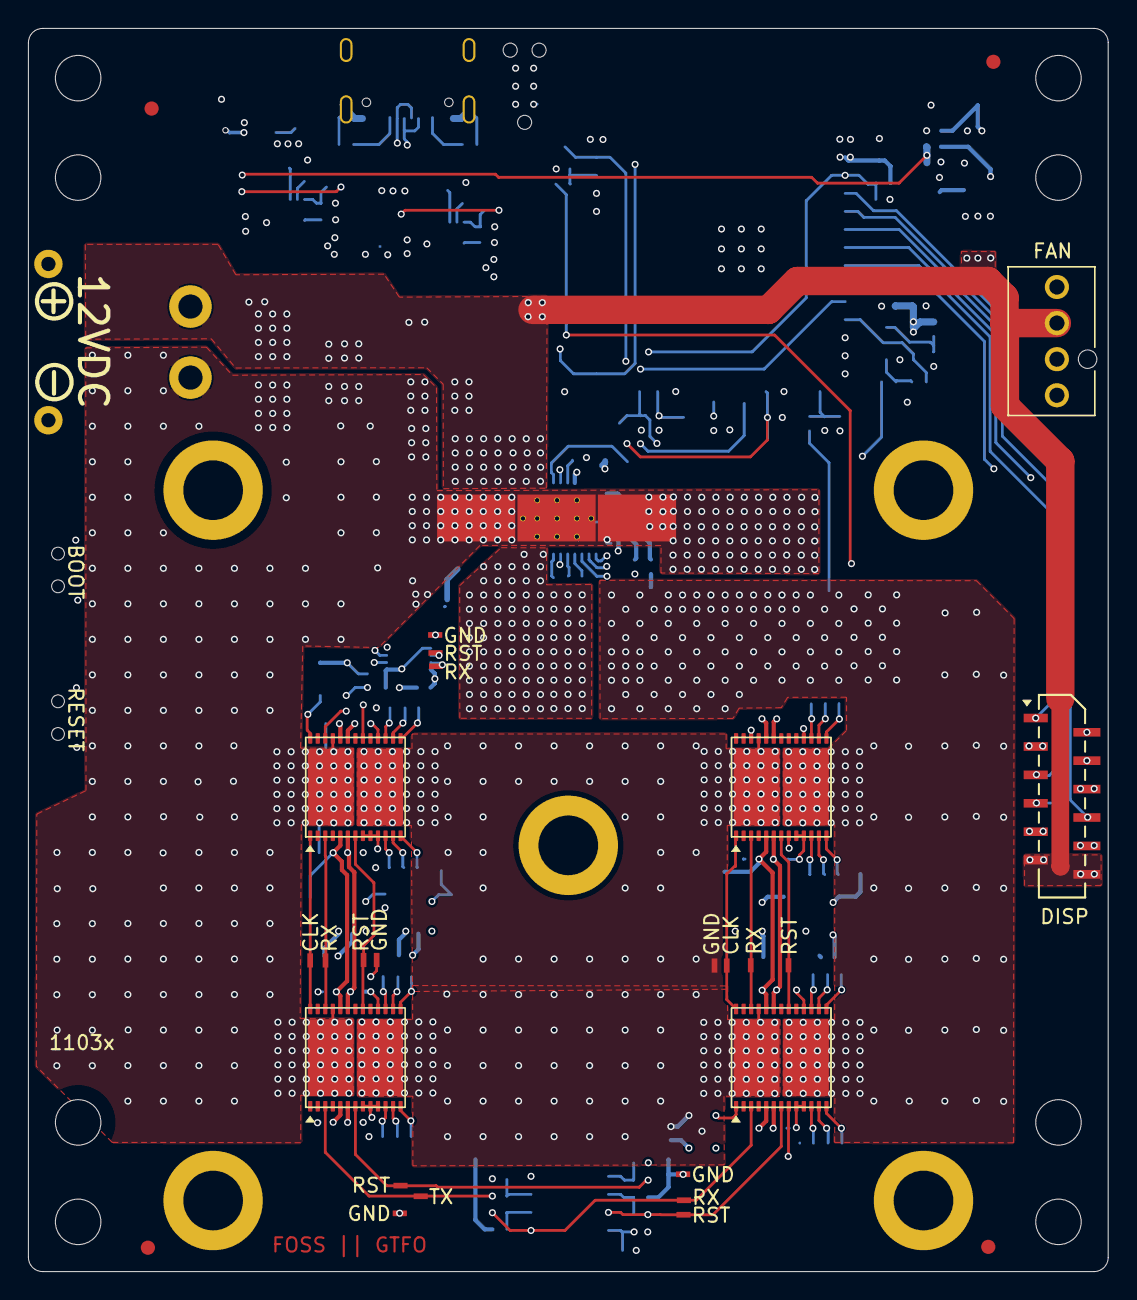
[picture p8: board bitaxeProto.kicad_pcb from above]

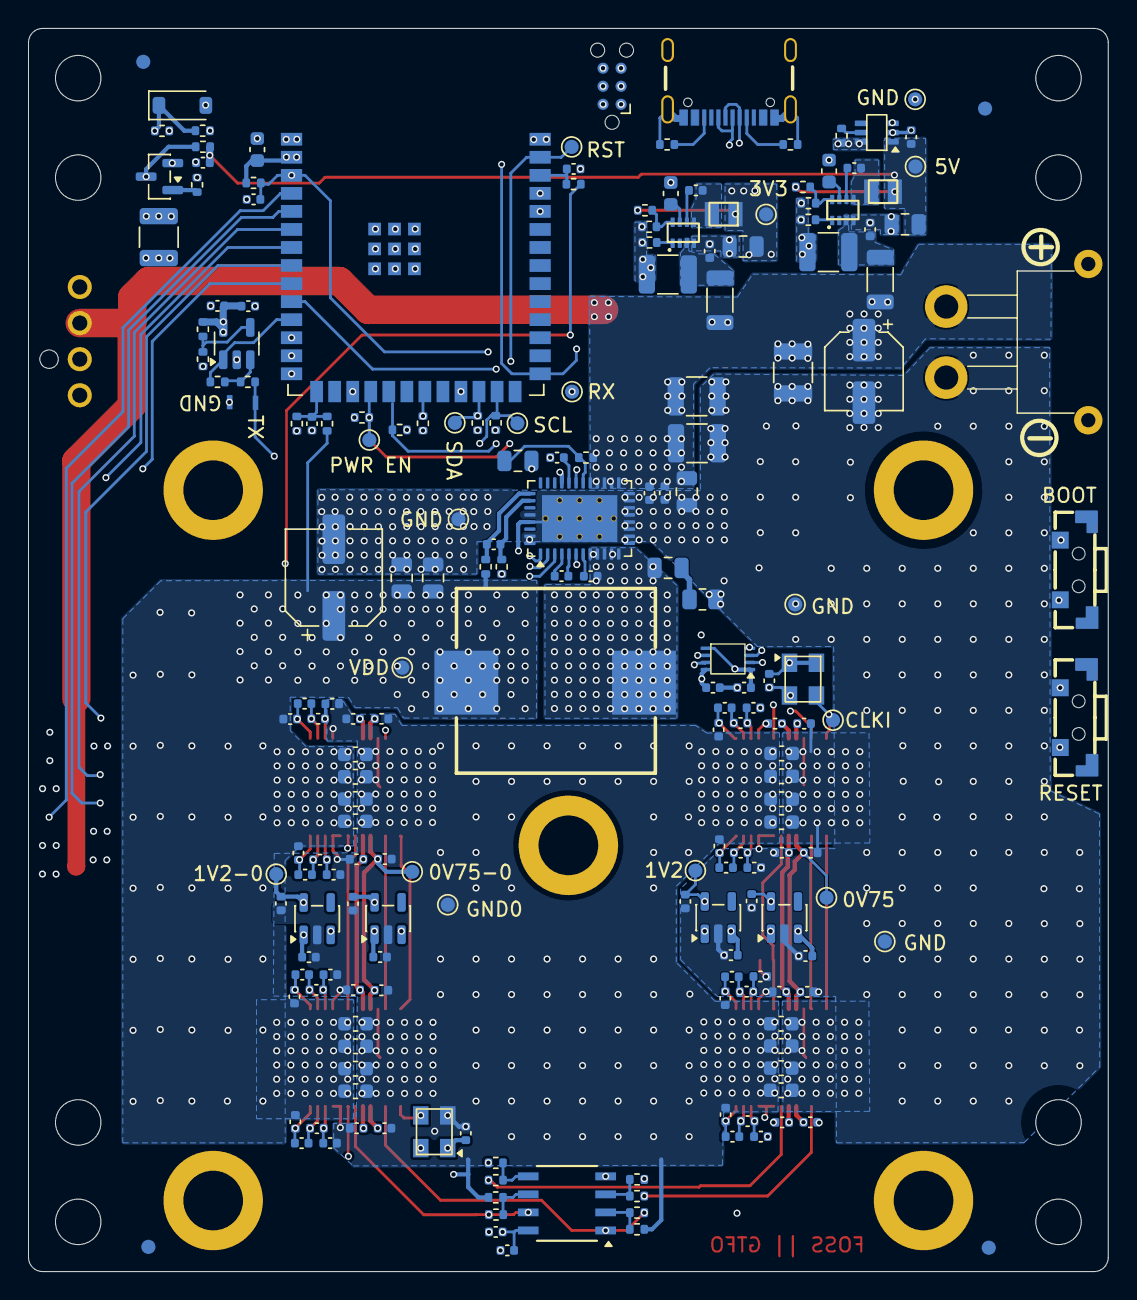
[picture p9: board bitaxeProto.kicad_pcb from below]

Board: 6 copper layers, 76.0 x 87.5 mm, 237 parts (204 on the bottom side), 109 nets.
