bitaxeorg/bitaxeproto/bitaxeProto-1102x.kicad_pcb

## KiCad design bitaxeProto-1102x.kicad_pcb (2026-05-12)

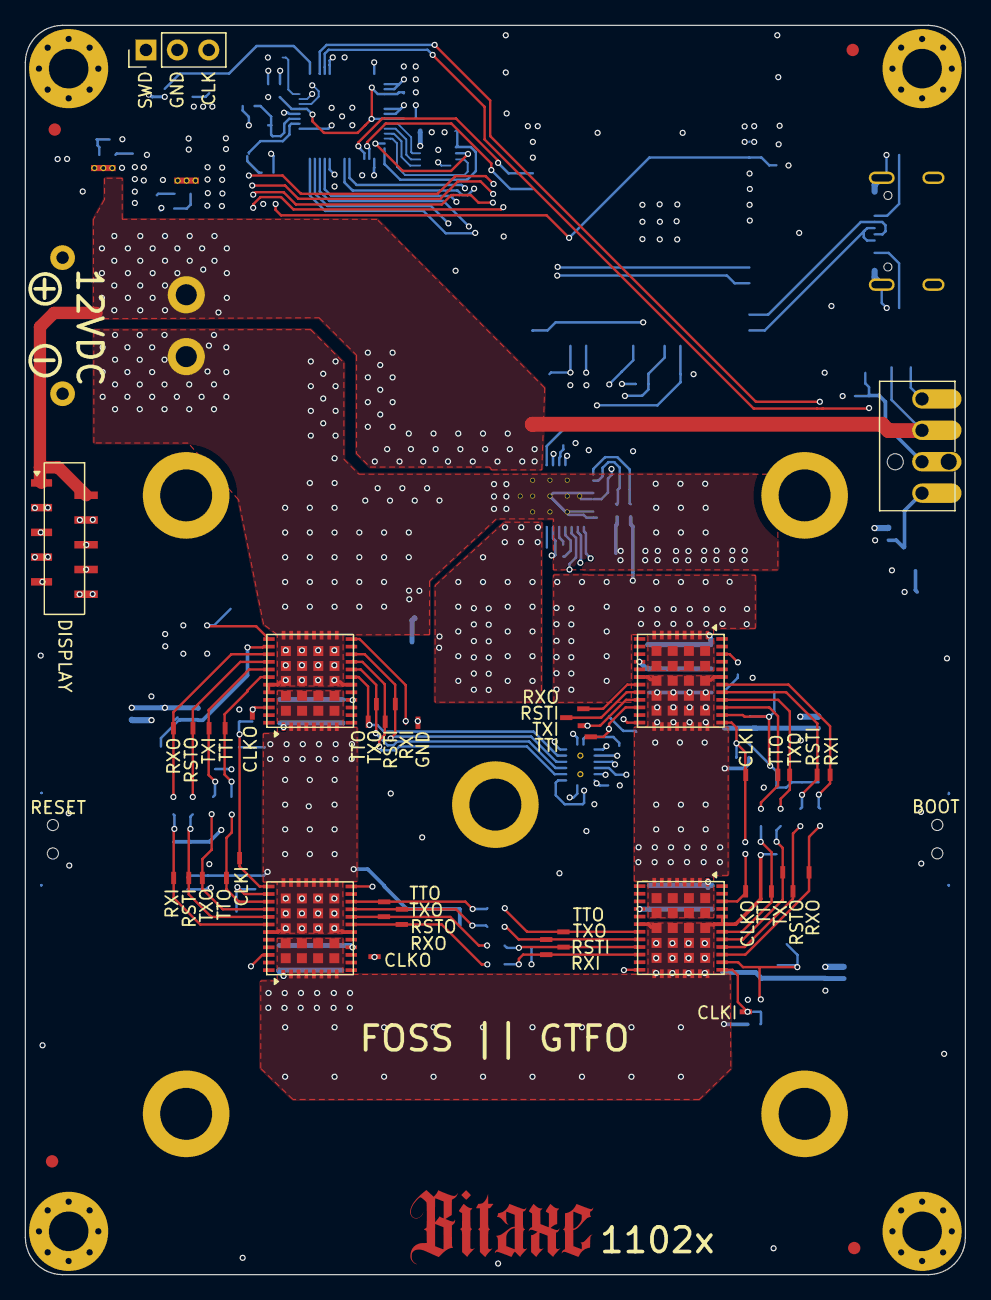
[picture p10: board bitaxeProto-1102x.kicad_pcb from above]

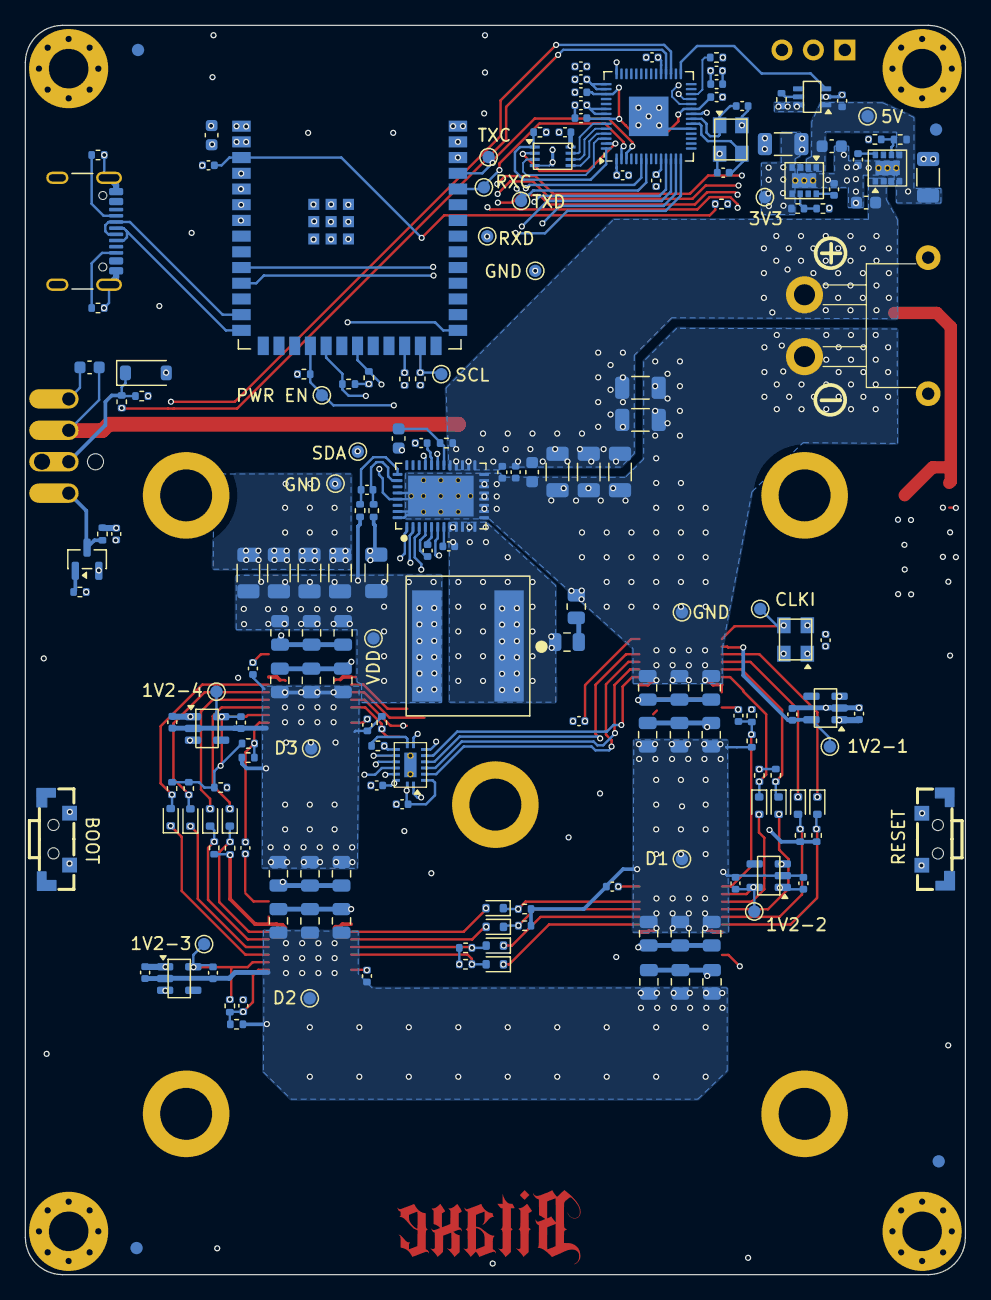
[picture p11: board bitaxeProto-1102x.kicad_pcb from below]

Board: 6 copper layers, 76.0 x 101.0 mm, 241 parts (188 on the bottom side), 122 nets.

Parts:
A1, A3: BZM2_MODE0; bzm2
A2, A4: BZM2_MODE1; bzm2
C1, C8, C47, C76: 10uF; C_0603_1608Metric
C2, C3, C4, C5, C6, C30, C31: 22uF; C_1206_3216Metric
C7, C15, C19, C25, C26, C27, C28, C34, C38, C39, C68, C72: 1uF; C_0402_1005Metric
C9, C10: 1uF; C_0603_1608Metric
C11: 4.7uF; C_0402_1005Metric
C12, C29: 3.3nF; C_0402_1005Metric
C13: 4.7nF; C_0402_1005Metric
C14: 2.2nF; C_0402_1005Metric
C16, C32, C36, C37, C40, C41, C42, C43, C44, C45, C46, C57, C58, C59, C77: 0.1uF; C_0402_1005Metric
C17: 1000pF; C_0805_2012Metric
C18: 100pF; C_0402_1005Metric
C20: 47uF; C_1206_3216Metric
C21, C22, C23, C24: 100uF; C_1206_3216Metric
C33, C35: 30pF; C_0402_1005Metric
C48: 12pF; C_0402_1005Metric
C60, C61, C62, C63, C64: 120pF; C_0402_1005Metric
C83, C84, C85, C91, C92, C93, C99, C100, C101, C107, C108, C109, C115, C116, C117, C123, C124, C125, C131, C132, C133, C139, C140, C141: 100uF; C_0805_2012Metric
C142, C143, C144: 1000pF; C_0402_1005Metric
D1, D2, D3, D4, D5, D6, D7, D8, D9, D10, D11, D12: DLLFSD01T-7; D_SOD-523
D13: 3.3V Zener; D_SOD-123
FID1, FID2, FID3, FID4: Fiducial; Fiducial_1mm_Mask2mm
H1, H2, H3, H4: MountingHole_Pad; MountingHole_3.2mm_M3_Pad_Via
HS1: Heatsink; Heatsink-5hole-BitaxeGT
J1: XT30; XT30PW-M
J2: Conn_01x03; PinHeader_1x03_P2.54mm_Vertical
J4: Conn_01x04; 470531000
J5: Conn_01x10; CONN10_1-1735042-0
J6: USB_C_Receptacle_USB2.0; USB_C_Receptacle_GCT_USB4105-xx-A
L1: 1.2uH; XAL1060122MEC
NT1: NetTie_2; NetTie-2_SMD_Pad0.2mmx1mm
Q1: BSS138; SOT-23
R1, R4, R17, R35, R36, R37, R38, R39, R40, R41, R42, R43, R44, R45, R46, R47, R48, R49, R50, R51, R52: 1k; R_0402_1005Metric
R2, R3, R9, R14, R22, R34: 10k; R_0402_1005Metric
R5: 10; R_0402_1005Metric
R6: 1; R_0805_2012Metric
R7, R8: 49.9; R_0402_1005Metric
R10: 536k; R_0402_1005Metric
R11, R13: 100k; R_0402_1005Metric
R12: 309k; R_0402_1005Metric
R16: 49.9k; R_0402_1005Metric
R18, R19, R20, R21: 4.7k; R_0402_1005Metric
R23, R24: 5.1k; R_0402_1005Metric
R26: 20k; R_0402_1005Metric
R33: 5.6k; R_0402_1005Metric
SW3, SW4: SWITCH-SPST; SW-SMD_TC-S3601-3.5-260G-F0.6
TP1: PWR EN; TestPoint_Pad_D1.0mm
TP2: 1V2-2; TestPoint_Pad_D1.0mm
TP3: 1V2-3; TestPoint_Pad_D1.0mm
TP4: 1V2-4; TestPoint_Pad_D1.0mm
TP5: SDA; TestPoint_Pad_D1.0mm
TP6, TP13, TP32, TP51, TP55: RSTI; TestPoint_Pad_1.0x0.4mm
TP7: VDD; TestPoint_Pad_D1.0mm
TP8: SCL; TestPoint_Pad_D1.0mm
TP9: 3V3; TestPoint_Pad_D1.0mm
TP10: CLKI; TestPoint_Pad_D1.0mm
TP11, TP28, TP43: TTI; TestPoint_Pad_1.0x0.4mm
TP12, TP29, TP44: TXI; TestPoint_Pad_1.0x0.4mm
TP14, TP31, TP38, TP46: RXO; TestPoint_Pad_1.0x0.4mm
TP15: 5V; TestPoint_Pad_D1.0mm
TP16: TXC; TestPoint_Pad_D1.0mm
TP17, TP33, TP40, TP50, TP54: TXO; TestPoint_Pad_1.0x0.4mm
TP18: 1V2-1; TestPoint_Pad_D1.0mm
TP19, TP26, TP27: GND; TestPoint_Pad_D1.0mm
TP20, TP36, TP52, TP56: RXI; TestPoint_Pad_1.0x0.4mm
TP21, TP34, TP41, TP49, TP53: TTO; TestPoint_Pad_1.0x0.4mm
TP22: GND; TestPoint_Pad_1.0x0.4mm
TP23: RXC; TestPoint_Pad_D1.0mm
TP24: TXD; TestPoint_Pad_D1.0mm
TP25: RXD; TestPoint_Pad_D1.0mm
TP30, TP39, TP45: RSTO; TestPoint_Pad_1.0x0.4mm
TP35, TP48, TP57: CLKI; TestPoint_Pad_1.0x0.4mm
TP37, TP42, TP47: CLKO; TestPoint_Pad_1.0x0.4mm
TP58: D1; TestPoint_Pad_D1.0mm
TP59: D2; TestPoint_Pad_D1.0mm
TP60: D3; TestPoint_Pad_D1.0mm
U1, U3, U4, U6: MCP1824T-1202E/OT; SOT-23-5
U2: TPS546D24SRVFR; LQFN40-CLIP
U5: W25Q16JVUXIQ TR; USON-8_UX_2x3x0p6_WIN
U7, U10: TPS82130; Texas_SIL0008D_MicroSiP-8-1EP_2.8x3mm_P0.65mm_EP1.1x1.9mm_T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
U8: SN74AXC4T774; BQB0016A-MFG
U9: TPS22919DCKR; DCK0006A_N
U11: RP2040; RP2040-QFN-56-1EP_7x7mm_P0.4mm_EP3.2x3.2mm
U12: ESP32-S3-WROOM-1
Y1: 12MHz; XTAL_ECS-120-20-33-CKM-TR3
Y2: 50MHz; OSC_ECS-3225MV-500-CN-TR

Connections:
/3V3: C31.2, C32.2, C39.2, C40.2, C41.2, C42.2, C43.2, C44.2, C45.2, C46.2, C47.1, C59.1, R12.2, R14.1, R16.2, R18.1, R19.2, R20.2, R21.2, R22.2, R33.2, TP9.1 (1_1), U5.8 (VCC), U8.15 (VCCB), U10.4 (VOUT), U10.5 (VOUT), U11.1 (IOVDD), U11.10 (IOVDD), U11.22 (IOVDD), U11.33 (IOVDD), U11.42 (IOVDD), U11.43 (ADC_AVDD), U11.44 (VREG_IN), U11.48 (USB_VDD), U11.49 (IOVDD), U12.2 (3V3)
/5V: C8.2, C30.2, C34.1, C77.1, R10.2, R34.2, TP15.1 (1_1), U7.4 (VOUT), U7.5 (VOUT), U9.1 (IN), U10.1 (EN), U10.2 (VIN)
/5V_SWITCH: C7.2, C25.2, C27.2, C68.2, R17.1, U1.1 (VIN), U1.3 (EN), U3.1 (VIN), U3.3 (EN), U4.1 (VIN), U4.3 (EN), U6.1 (VIN), U6.3 (EN), U9.6 (OUT)
/12V: C1.2, C2.1, C3.1, C4.1, C5.1, C6.1, C9.1, C13.1, C14.1, C76.1, J1.1 (+V), J4.2, J5.1, J5.2, R5.1, U2.21 (PVIN), U2.22 (PVIN), U2.23 (PVIN), U2.24 (PVIN), U2.25 (PVIN), U7.1 (EN), U7.2 (VIN)
/ASIC/1V2-1: A1.30 (VDDIO), C57.1, C58.1, C72.2, TP18.1 (1_1), U6.5 (VOUT), U8.2 (DIR2), U8.8 (DIR4), U8.16 (VCCA), Y2.1 (EN), Y2.4 (VIN)
/ASIC/1V2-2: A2.30 (VDDIO), C19.2, R37.2, R38.1, R39.1, TP2.1 (1_1), U1.5 (VOUT)
/ASIC/1V2-3: A3.30 (VDDIO), C26.2, R43.2, R44.1, R45.1, TP3.1 (1_1), U3.5 (VOUT)
/ASIC/1V2-4: A4.30 (VDDIO), C28.2, R4.1, R49.2, R50.1, R51.1, TP4.1 (1_1), U4.5 (VOUT)
/ASIC/GND2: A1.2 (VDD), A1.3 (VDD), A1.4 (VDD), A1.5 (VDD), A1.6 (VDD), A1.7 (VDD), A1.8 (VDD), A1.41 (VDD), A1.42 (VDD), A1.49 (VDD), A1.50 (VDD), A1.51 (VDD), A1.52 (VDD), A1.59 (VDD), A1.60 (VDD), A2.14 (VSS), A2.21 (VSS), A2.22 (VSS), A2.23 (VSS), A2.24 (VSS), A2.25 (VSS), A2.26 (VSS), A2.27 (VSS), A2.28 (VSS), A2.35 (VSS), A2.43 (VSS), A2.44 (VSS), A2.45 (VSS), A2.46 (VSS), A2.47 (VSS), A2.48 (VSS), A2.53 (VSS), A2.54 (VSS), A2.55 (VSS), A2.56 (VSS), A2.57 (VSS), A2.58 (VSS), C7.1, C19.1, C63.2, C83.2, C84.2, C85.2, C107.1, C108.1, C109.1, R40.2, R41.2, R42.2, TP58.1 (1_1), U1.2 (GND)
/ASIC/GND3: A2.2 (VDD), A2.3 (VDD), A2.4 (VDD), A2.5 (VDD), A2.6 (VDD), A2.7 (VDD), A2.8 (VDD), A2.41 (VDD), A2.42 (VDD), A2.49 (VDD), A2.50 (VDD), A2.51 (VDD), A2.52 (VDD), A2.59 (VDD), A2.60 (VDD), A3.14 (VSS), A3.21 (VSS), A3.22 (VSS), A3.23 (VSS), A3.24 (VSS), A3.25 (VSS), A3.26 (VSS), A3.27 (VSS), A3.28 (VSS), A3.35 (VSS), A3.36 (PINSEL), A3.43 (VSS), A3.44 (VSS), A3.45 (VSS), A3.46 (VSS), A3.47 (VSS), A3.48 (VSS), A3.53 (VSS), A3.54 (VSS), A3.55 (VSS), A3.56 (VSS), A3.57 (VSS), A3.58 (VSS), C25.1, C26.1, C62.2, C99.2, C100.2, C101.2, C123.1, C124.1, C125.1, R46.2, R47.2, R48.2, TP59.1 (1_1), U3.2 (GND)
/ASIC/GND4: A3.2 (VDD), A3.3 (VDD), A3.4 (VDD), A3.5 (VDD), A3.6 (VDD), A3.7 (VDD), A3.8 (VDD), A3.41 (VDD), A3.42 (VDD), A3.49 (VDD), A3.50 (VDD), A3.51 (VDD), A3.52 (VDD), A3.59 (VDD), A3.60 (VDD), A4.14 (VSS), A4.21 (VSS), A4.22 (VSS), A4.23 (VSS), A4.24 (VSS), A4.25 (VSS), A4.26 (VSS), A4.27 (VSS), A4.28 (VSS), A4.35 (VSS), A4.43 (VSS), A4.44 (VSS), A4.45 (VSS), A4.46 (VSS), A4.47 (VSS), A4.48 (VSS), A4.53 (VSS), A4.54 (VSS), A4.55 (VSS), A4.56 (VSS), A4.57 (VSS), A4.58 (VSS), C27.1, C28.1, C60.2, C61.2, C115.2, C116.2, C117.2, C139.1, C140.1, C141.1, R9.2, R52.2, TP60.1 (1_1), U4.2 (GND)
/ASIC/REFCLKIN1: A1.29 (REFCLKIN), TP10.1 (1_1), Y2.3 (OUT)
/ASIC/REFCLKIN2: A2.29 (REFCLKIN), C142.2, R39.2, R40.1, TP35.1 (1_1)
/ASIC/REFCLKIN3: A3.29 (REFCLKIN), C143.2, R45.2, R46.1, TP57.1 (1_1)
/ASIC/REFCLKIN4: A4.29 (REFCLKIN), C144.2, R51.2, R52.1, TP48.1 (1_1)
/ASIC/REFCLKOUT1: A1.38 (REFCLKOUT1), C142.1, TP37.1 (1_1)
/ASIC/REFCLKOUT2: A2.38 (REFCLKOUT1), C143.1, TP42.1 (1_1)
/ASIC/REFCLKOUT3: A3.38 (REFCLKOUT1), C144.1, TP47.1 (1_1)
/ASIC/RST_1V2: A1.17 (RESET_IN), TP6.1 (1_1), U8.3 (A1)
/ASIC/RST_3V3: U8.14 (B1), U11.14 (GPIO11)
/ASIC/RX_1V2: A1.18 (RX_IN), TP20.1 (1_1), U8.5 (A3)
/ASIC/RX_3V3: U8.12 (B3), U11.11 (GPIO8)
/ASIC/TRIP_1V2: A1.15 (TRIP_OUT), TP21.1 (1_1), U8.6 (A4)
/ASIC/TRIP_3V3: U8.11 (B4), U11.13 (GPIO10)
/ASIC/TX_1V2: A1.16 (TX_OUT), TP17.1 (1_1), U8.4 (A2)
/ASIC/TX_3V3: U8.13 (B2), U11.12 (GPIO9)
/ASIC/bypass1-1/out: A1.1 (VDD_INT_1), C83.1, C84.1, C85.1
/ASIC/bypass1-2/in: A1.12 (VDD_INT_2), C91.2, C92.2, C93.2
/ASIC/bypass2-1/out: A2.1 (VDD_INT_1), C99.1, C100.1, C101.1
/ASIC/bypass2-2/in: A2.12 (VDD_INT_2), C107.2, C108.2, C109.2
/ASIC/bypass3-1/out: A3.1 (VDD_INT_1), C115.1, C116.1, C117.1
/ASIC/bypass3-2/in: A3.12 (VDD_INT_2), C123.2, C124.2, C125.2
/ASIC/bypass4-1/out: A4.1 (VDD_INT_1), C131.1, C132.1, C133.1
/ASIC/bypass4-2/in: A4.12 (VDD_INT_2), C139.2, C140.2, C141.2
/ASIC/shifter1-2/RESET_IN: A2.33 (RESET_IN), D3.A, R37.1, TP32.1 (1_1)
/ASIC/shifter1-2/RESET_OUT: A1.32 (RESET_OUT), D3.K, TP30.1 (1_1)
/ASIC/shifter1-2/RX_IN: A2.34 (RX_IN), D4.A, R38.2, TP36.1 (1_1)
/ASIC/shifter1-2/RX_OUT: A1.31 (RX_OUT), D4.K, TP31.1 (1_1)
/ASIC/shifter1-2/TRIP_IN: A1.34 (TRIP_IN), D1.K, R35.1, TP28.1 (1_1)
/ASIC/shifter1-2/TRIP_OUT: A2.31 (TRIP_OUT), D1.A, TP34.1 (1_1)
/ASIC/shifter1-2/TX_IN: A1.33 (TX_IN), D2.K, R36.1, TP29.1 (1_1)
/ASIC/shifter1-2/TX_OUT: A2.32 (TX_OUT), D2.A, TP33.1 (1_1)
/ASIC/shifter2-3/RESET_IN: A3.17 (RESET_IN), D7.A, R43.1, TP55.1 (1_1)
/ASIC/shifter2-3/RESET_OUT: A2.16 (RESET_OUT), D7.K, TP39.1 (1_1)
/ASIC/shifter2-3/RX_IN: A3.18 (RX_IN), D8.A, R44.2, TP56.1 (1_1)
/ASIC/shifter2-3/RX_OUT: A2.15 (RX_OUT), D8.K, TP38.1 (1_1)
/ASIC/shifter2-3/TRIP_IN: A2.18 (TRIP_IN), D5.K, R41.1, TP41.1 (1_1)
/ASIC/shifter2-3/TRIP_OUT: A3.15 (TRIP_OUT), D5.A, TP53.1 (1_1)
/ASIC/shifter2-3/TX_IN: A2.17 (TX_IN), D6.K, R42.1, TP40.1 (1_1)
/ASIC/shifter2-3/TX_OUT: A3.16 (TX_OUT), D6.A, TP54.1 (1_1)
/ASIC/shifter3-4/RESET_IN: A4.33 (RESET_IN), D11.A, R49.1, TP51.1 (1_1)
/ASIC/shifter3-4/RESET_OUT: A3.32 (RESET_OUT), D11.K, TP45.1 (1_1)
/ASIC/shifter3-4/RX_IN: A4.34 (RX_IN), D12.A, R50.2, TP52.1 (1_1)
/ASIC/shifter3-4/RX_OUT: A3.31 (RX_OUT), D12.K, TP46.1 (1_1)
/ASIC/shifter3-4/TRIP_IN: A3.34 (TRIP_IN), D9.K, R47.1, TP43.1 (1_1)
/ASIC/shifter3-4/TRIP_OUT: A4.31 (TRIP_OUT), D9.A, TP49.1 (1_1)
/ASIC/shifter3-4/TX_IN: A3.33 (TX_IN), D10.K, R48.1, TP44.1 (1_1)
/ASIC/shifter3-4/TX_OUT: A4.32 (TX_OUT), D10.A, TP50.1 (1_1)
/Data/1V1: C36.2, C37.2, C38.2, U11.23 (DVDD), U11.45 (VREG_VOUT), U11.50 (DVDD)
/Data/5V_EN: U9.3 (ON), U11.29 (GPIO18)
/Data/DISP_GPIO1: J5.5, U12.4 (GPIO4/TOUCH4/ADC1_CH3)
/Data/DISP_GPIO2: J5.6, U12.5 (GPIO5/TOUCH5/ADC1_CH4)
/Data/DISP_SCL: J5.8, U12.6 (GPIO6/TOUCH6/ADC1_CH5)
/Data/DISP_SDA: J5.9, U12.7 (GPIO7/TOUCH7/ADC1_CH6)
/Data/EN: C48.1, R22.1, SW3.2, U12.3 (EN)
/Data/ESP32_RX_CTRL: TP23.1 (1_1), U11.2 (GPIO0), U12.36 (U0RXD/GPIO44/CLK_OUT2)
/Data/ESP32_RX_DATA: TP25.1 (1_1), U11.6 (GPIO4), U12.11 (GPIO18/U1RXD/ADC2_CH7/CLK_OUT3)
/Data/ESP32_TX_CTRL: TP16.1 (1_1), U11.3 (GPIO1), U12.37 (U0TXD/GPIO43/CLK_OUT1)
/Data/ESP32_TX_DATA: TP24.1 (1_1), U11.7 (GPIO5), U12.10 (GPIO17/U1TXD/ADC2_CH6)
/Data/FAN_PWM: R1.2, U11.31 (GPIO20)
/Data/FAN_TACH: R2.2, U11.32 (GPIO21)
/Data/IO0: SW4.2, U12.27 (GPIO0/BOOT*)
/Data/PWR_EN: R3.2, TP1.1 (1_1), U2.27 (EN/UVLO), U12.18 (GPIO10/TOUCH10/ADC1_CH9/FSPICS0/FSPIIO4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)
/Data/QSPI_SCLK: U5.6 (CLK), U11.52 (QSPI_SCLK)
/Data/QSPI_SD0: U5.5 (DI(IO0)), U11.53 (QSPI_SD0)
/Data/QSPI_SD1: U5.2 (DO(IO1)), U11.55 (QSPI_SD1)
/Data/QSPI_SD2: U5.3 (/WP(IO2)), U11.54 (QSPI_SD2)
/Data/QSPI_SD3: U5.7 (/HOLDOR/RESET(IO3)), U11.51 (QSPI_SD3)
/Data/QSPI_SS: R14.2, U5.1 (/CS), U11.56 (QSPI_SS)
/Data/SCL: R19.1, TP8.1 (1_1), U2.3 (PMB_CLK), U12.25 (GPIO48/SPICLK_N/SUBSPICLK_N_DIFF)
/Data/SDA: R18.2, TP5.1 (1_1), U2.2 (PMB_DATA), U12.24 (GPIO47/SPICLK_P/SUBSPICLK_P_DIFF)
/Data/SMB_ALRT: R20.1, U2.6 (SMB_ALRT), U12.21 (GPIO13/TOUCH13/ADC2_CH2/FSPIQ/FSPIIO7/S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)
/Data/SWCLK: J2.3, U11.24 (SWCLK), U12.39 (GPIO1/TOUCH1/ADC1_CH0)
/Data/SWD: J2.1, U11.25 (SWD), U12.38 (GPIO2/TOUCH2/ADC1_CH1)
/Data/USB_D+: J6.A6 (D+), J6.B6 (D+), U12.14 (GPIO20/U1CTS/ADC2_CH9/CLK_OUT1/USB_D+)
/Data/USB_D-: J6.A7 (D-), J6.B7 (D-), U12.13 (GPIO19/U1RTS/ADC2_CH8/CLK_OUT2/USB_D-)
/Data/XIN: C35.2, U11.20 (XIN), Y1.3
/Data/XOUT: C33.2, U11.21 (XOUT), Y1.1
/Power/AGND: C10.1, NT1.2, U2.29 (MSEL2), U2.37 (AGND)
/Power/BP1v5: C15.1, U2.4 (BP1V5)
/Power/PGOOD: R21.1, U2.1 (PGD), U12.19 (GPIO11/TOUCH11/ADC2_CH0/FSPID/FSPIIO5/S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)
/Power/SW1: C16.2, C17.1, L1.1, U2.8 (SW), U2.9 (SW), U2.10 (SW), U2.11 (SW), U2.12 (SW)
/Power/V5reg_1: C11.2, U2.28 (VDD5)
/VDD: A4.2 (VDD), A4.3 (VDD), A4.4 (VDD), A4.5 (VDD), A4.6 (VDD), A4.7 (VDD), A4.8 (VDD), A4.41 (VDD), A4.42 (VDD), A4.49 (VDD), A4.50 (VDD), A4.51 (VDD), A4.52 (VDD), A4.59 (VDD), A4.60 (VDD), C20.2, C21.2, C22.2, C23.2, C24.2, C131.2, C132.2, C133.2, L1.2, R7.1, TP7.1 (1_1)
/fan/FAN_PWM_PIN: J4.4, Q1.3 (D), R34.1
/fan/FAN_TACH_PIN: D13.1 (K), J4.3, R2.1, R33.1
GND: A1.14 (VSS), A1.21 (VSS), A1.22 (VSS), A1.23 (VSS), A1.24 (VSS), A1.25 (VSS), A1.26 (VSS), A1.27 (VSS), A1.28 (VSS), A1.35 (VSS), A1.36 (PINSEL), A1.43 (VSS), A1.44 (VSS), A1.45 (VSS), A1.46 (VSS), A1.47 (VSS), A1.48 (VSS), A1.53 (VSS), A1.54 (VSS), A1.55 (VSS), A1.56 (VSS), A1.57 (VSS), A1.58 (VSS), C1.1, C2.2, C3.2, C4.2, C5.2, C6.2, C8.1, C9.2, C11.1, C12.1, C13.2, C14.2, C20.1, C21.1, C22.1, C23.1, C24.1, C29.1, C30.1, C31.1, C32.1, C33.1, C34.2, C35.1, C36.1, C37.1, C38.1, C39.1, C40.1, C41.1, C42.1, C43.1, C44.1, C45.1, C46.1, C47.2, C48.2, C57.2, C58.2, C59.2, C64.2, C68.1, C72.1, C76.2, C77.2, C91.1, C92.1, C93.1, D13.2 (A), H1.1 (1_1), H2.1 (1_1), H3.1 (1_1), H4.1 (1_1), J1.2 (GND), J2.2, J4.1, J5.3, J5.4, J5.7, J5.10, J6.A1 (GND), J6.B1 (GND), J6.S1 (SHIELD), NT1.1, Q1.2 (S), R3.1, R6.2, R8.2, R11.1, R13.1, R23.1, R24.1, R26.1, R35.2, R36.2, SW3.1, SW4.1, TP19.1 (1_1), TP22.1 (1_1), TP26.1 (1_1), TP27.1 (1_1), U2.13 (PGND), U2.14 (PGND), U2.15 (PGND), U2.16 (PGND), U2.17 (PGND), U2.18 (PGND), U2.19 (PGND), U2.20 (PGND), U2.36 (NC), U2.39 (BCX_CLK), U2.40 (BCX_DAT), U2.41 (PAD), U5.4 (GND), U5.9 (EPAD), U6.2 (GND), U7.3 (GND), U7.9 (GND), U8.1 (DIR1), U8.7 (DIR3), U8.10 (GND), U9.2 (GND), U10.3 (GND), U10.9 (GND), U11.19 (TESTEN), U11.57 (GND), U12.1 (GND), U12.40 (GND), U12.41 (GND), Y1.2, Y1.4, Y2.2 (GND)
unnamed: A1.20 (REFCLKOUT2), C64.1
unnamed: A2.20 (REFCLKOUT2), C63.1
unnamed: A3.20 (REFCLKOUT2), C62.1
unnamed: A4.38 (REFCLKOUT1), C60.1
unnamed: A4.20 (REFCLKOUT2), C61.1
unnamed: A4.16 (RESET_OUT), TP13.1 (1_1)
unnamed: A4.15 (RX_OUT), TP14.1 (1_1)
unnamed: A4.18 (TRIP_IN), R9.1, TP11.1 (1_1)
unnamed: A4.17 (TX_IN), R4.2, TP12.1 (1_1)
unnamed: C17.2, R6.1
unnamed: J6.A5 (CC1), R23.2
unnamed: J6.B5 (CC2), R24.2
unnamed: Q1.1 (G), R1.1
unnamed: C10.2, R5.2, U2.26 (AVIN)
unnamed: C16.1, U2.7 (BOOT)
unnamed: C15.2, U2.5 (DRTN)
unnamed: C18.2, R8.1, U2.34 (GOSNS)
unnamed: C18.1, R7.2, U2.33 (VOSNS)
unnamed: R10.1, R11.2, U7.6 (FB)
unnamed: C12.2, U7.8 (SS/TR)
unnamed: R26.2, U8.9 (OE)
unnamed: R17.2, U9.5 (QOD)
unnamed: R12.1, R13.2, U10.6 (FB)
unnamed: C29.2, U10.8 (SS/TR)
unnamed: R16.1, U11.26 (RUN)
